sneakylizard123-4/STM32H743/images/schematic/03-clock.png

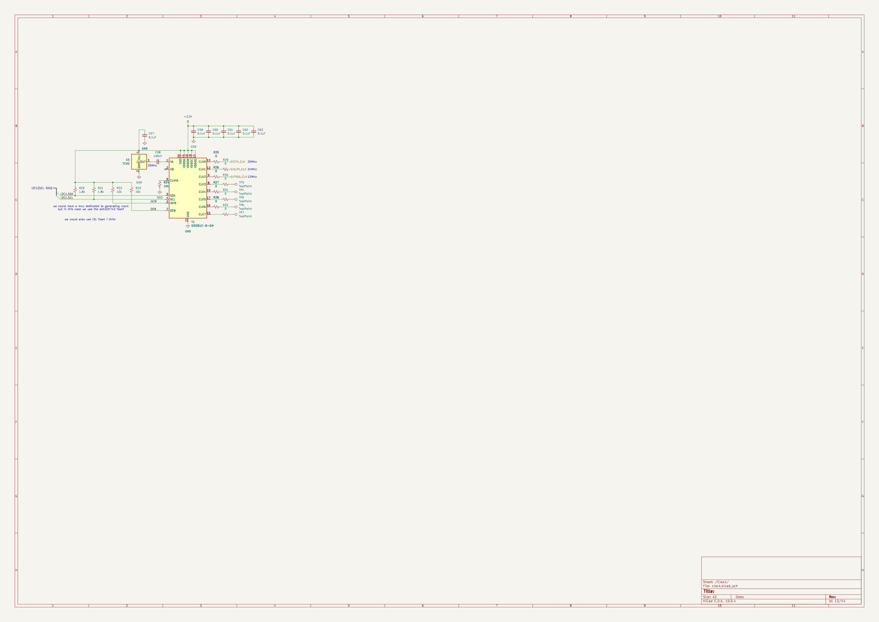
images/schematic/03-clock.png
