sneakylizard123-4/STM32H743/images/schematic/04-mcu.png

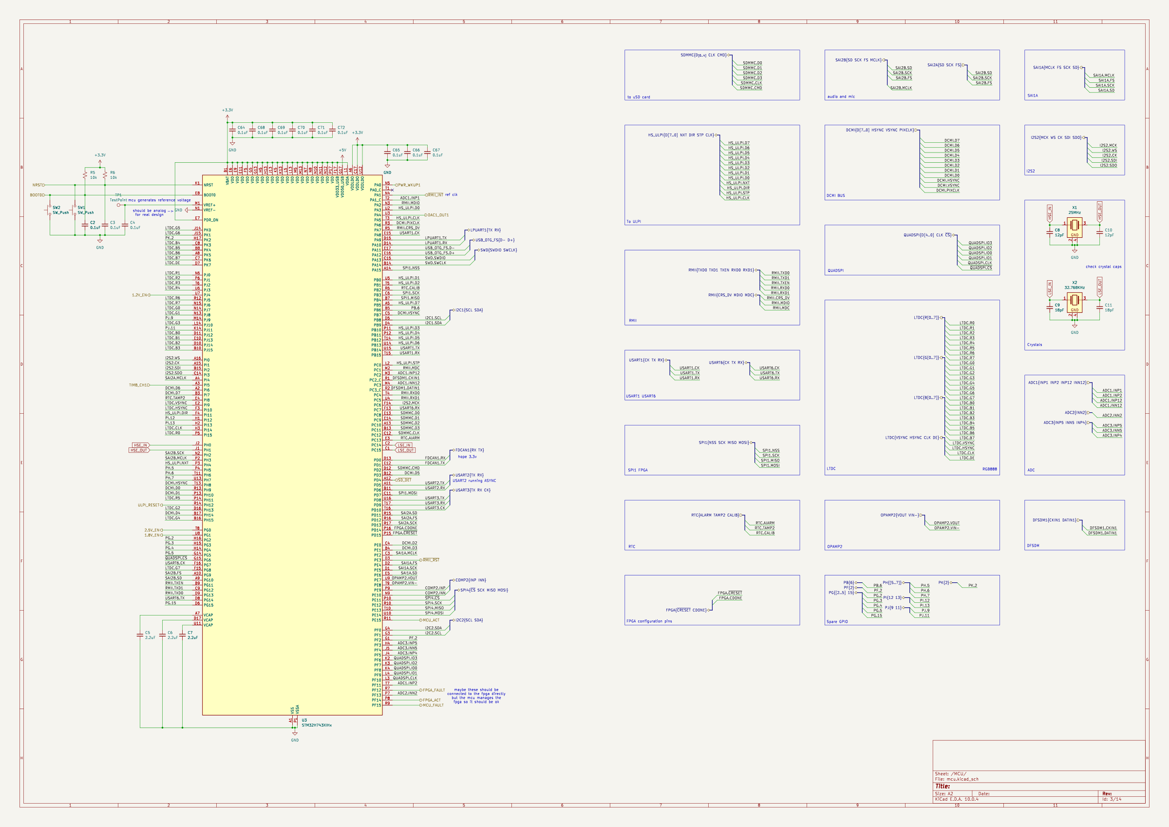
images/schematic/04-mcu.png
