sneakylizard123-4/STM32H743/images/schematic/05-fpga.png

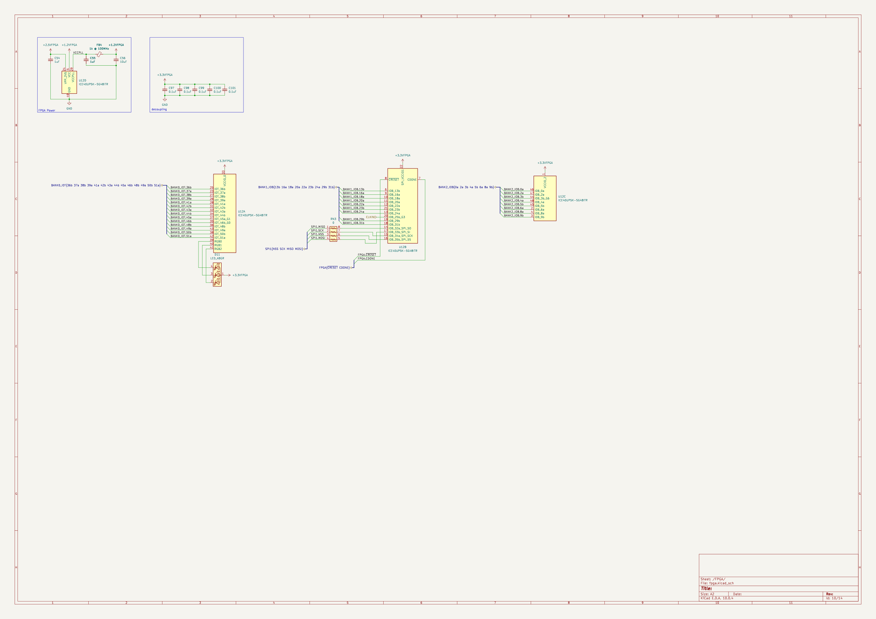
images/schematic/05-fpga.png
