sneakylizard123-4/STM32H743/images/schematic/06-ulpi.png

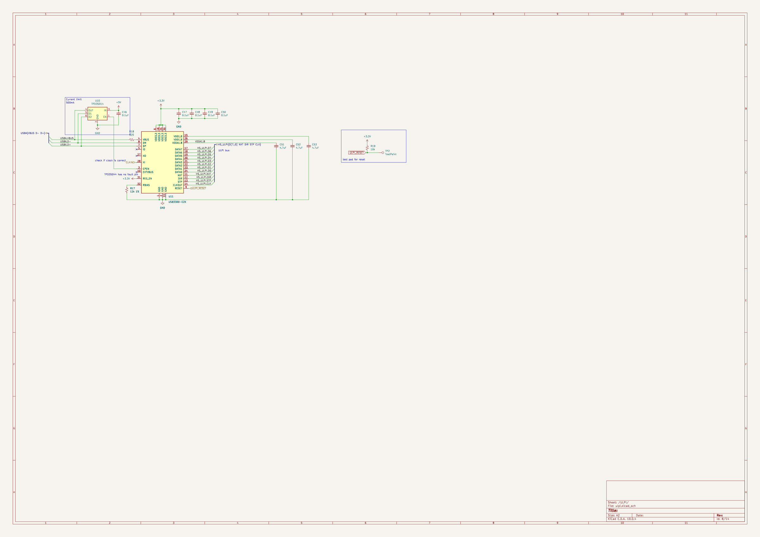
images/schematic/06-ulpi.png
