sneakylizard123-4/STM32H743/images/schematic/07-usb.png

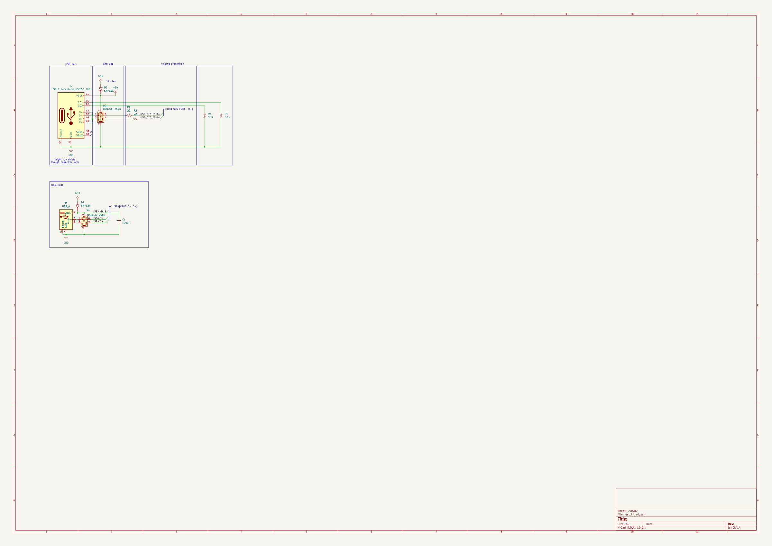
images/schematic/07-usb.png
