sneakylizard123-4/STM32H743/images/schematic/08-ethernet.png

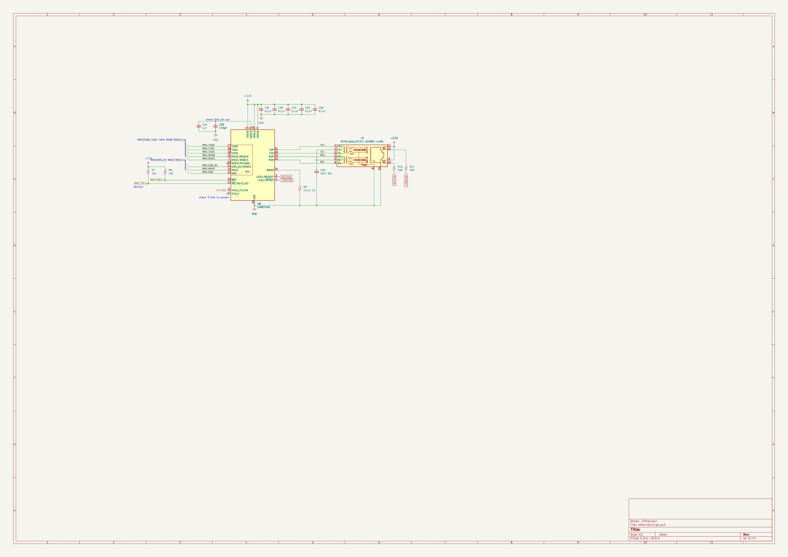
images/schematic/08-ethernet.png
