sneakylizard123-4/STM32H743/images/schematic/09-audio.png

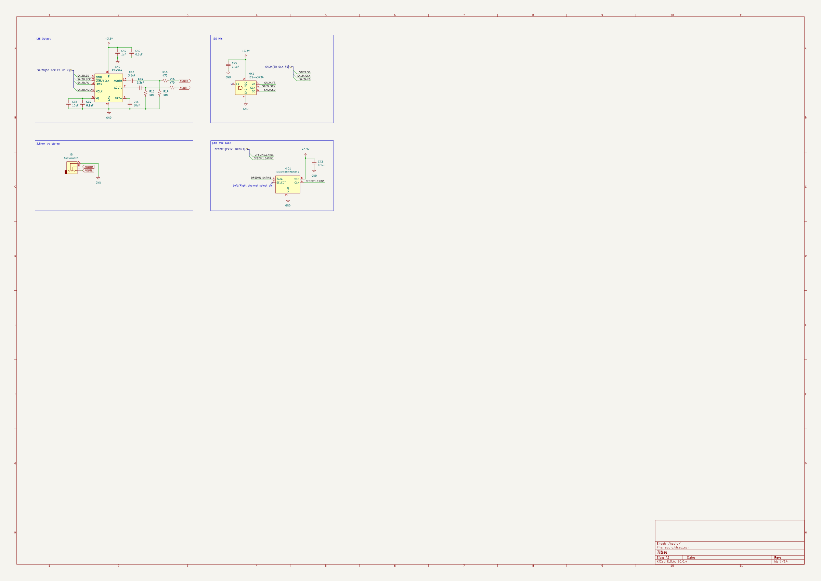
images/schematic/09-audio.png
