sneakylizard123-4/STM32H743/images/schematic/12-gpio.png

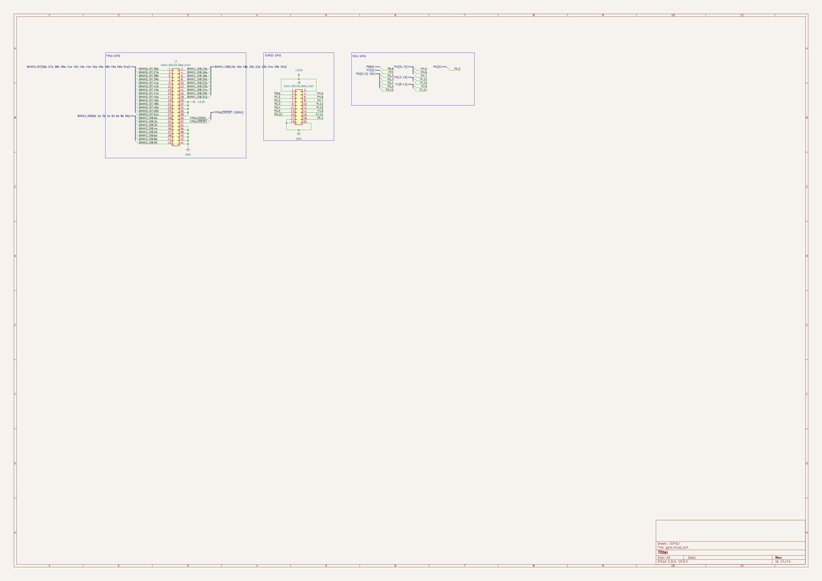
images/schematic/12-gpio.png
