sneakylizard123-4/STM32H743/images/schematic/13-connector.png

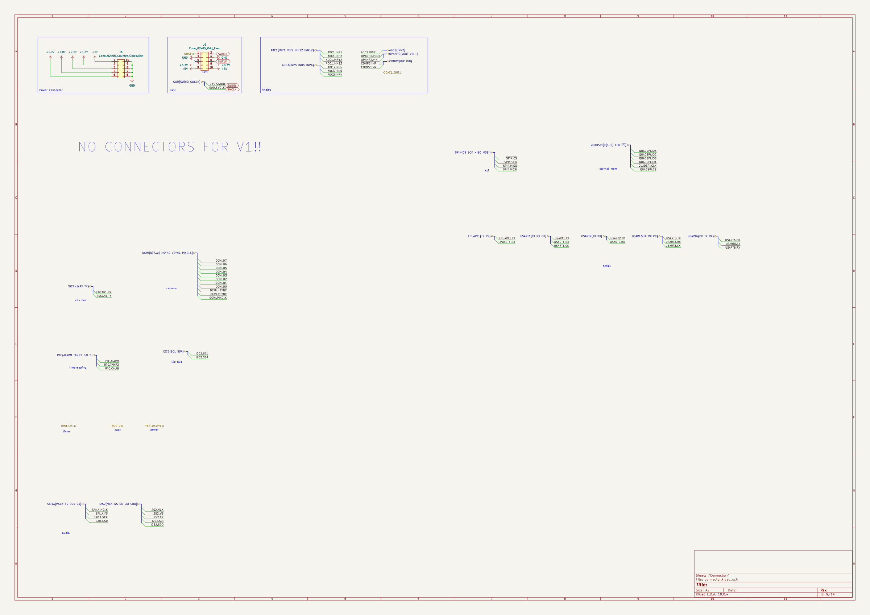
images/schematic/13-connector.png
