sneakylizard123-4/STM32H743/images/schematic/14-leds.png

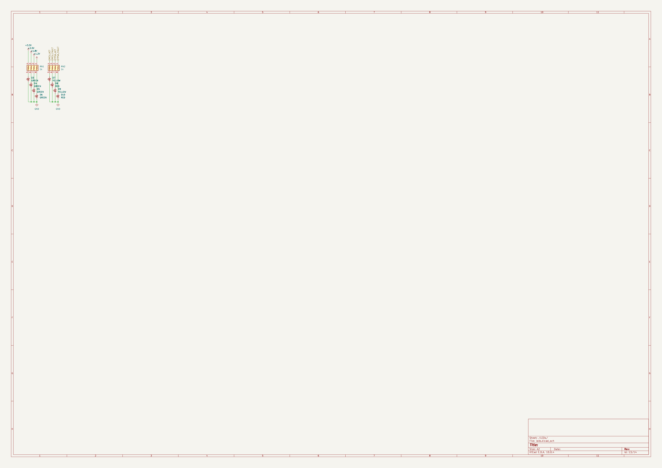
images/schematic/14-leds.png
