sneakylizard123-4/STM32H743/BOM.csv

Comment | Designators | Footprint | Quantity | Supplier | Supplier Part | Unit Price (USD) | Extended Price (USD) | Supplier Link | Notes
STM32H743XIH6 | U3 | TFBGA-265 | 1 | LCSC | C114407 | 25.9662 | 25.9662 | https://www.lcsc.com/product-detail/C114407.html | Main MCU, 480 MHz, 2 MB flash
ICE40UP5K-SG48I | U12 | QFN-48-EP 7x7 | 1 | LCSC | C2678152 | 10.9007 | 10.9007 | https://www.lcsc.com/product-detail/C2678152.html | Substitute for obsolete ICE40UP5K-SG48ITR, same package
USB3300-EZK-TR | U11 | QFN-32 | 1 | LCSC | C108383 | 1.4647 | 1.4647 | https://www.lcsc.com/product-detail/C108383.html | USB 2.0 HS ULPI PHY
LAN8742A-CZ-TR | U8 | QFN-24-EP 4x4 | 1 | LCSC | C621424 | 1.4025 | 1.4025 | https://www.lcsc.com/product-detail/C621424.html | 10/100 Ethernet PHY
CS4344-CZZR | U9 | TSSOP-10 | 1 | LCSC | C8952 | 1.5154 | 1.5154 | https://www.lcsc.com/product-detail/C8952.html | Stereo I2S audio DAC
Si5351C-B-GM | Y1 | QFN-20 | 1 | LCSC | C3608122 | 5.5527 | 5.5527 | https://www.lcsc.com/product-detail/C3608122.html | Clock generator
TLV75733PDBV | U4 | SOT-23-5 | 1 | LCSC | C485517 | 0.2005 | 0.2005 | https://www.lcsc.com/product-detail/C485517.html | 3.3 V LDO
TLV75725PDBV | U5 | SOT-23-5 | 1 | LCSC | C2872563 | 0.2318 | 0.2318 | https://www.lcsc.com/product-detail/C2872563.html | 2.5 V LDO
TLV75718PDBV | U6 | SOT-23-5 | 1 | LCSC | C507270 | 0.2985 | 0.2985 | https://www.lcsc.com/product-detail/C507270.html | 1.8 V LDO
TLV75712PDBV | U7 | SOT-23-5 | 1 | LCSC | C1509296 | 0.3415 | 0.3415 | https://www.lcsc.com/product-detail/C1509296.html | 1.2 V LDO
USBLC6-2SC6 | U1 U2 | SOT-23-6 | 2 | LCSC | C7519 | 0.1797 | 0.3594 | https://www.lcsc.com/product-detail/C7519.html | USB ESD protection
TPD3S014DBVR | U10 | SOT-23-6 | 1 | LCSC | C87384 | 1.0327 | 1.0327 | https://www.lcsc.com/product-detail/C87384.html | USB-A host power switch and protection
ICS-43434 | MK1 | LGA-6 3.5x2.7 | 1 | LCSC | C5656610 | 4.6035 | 4.6035 | https://www.lcsc.com/product-detail/C5656610.html | PDM microphone
MMICT390200012 | MIC1 | LGA | 1 | LCSC | C3171752 | 1.5613 | 1.5613 | https://www.lcsc.com/product-detail/C3171752.html | PDM microphone
CLMVC-FKA-CLBDGL7LBB79353 | D11 | PLCC-4 | 1 | Mouser | 941-CLMVCFKACLBDGL7L | 0.1400 | 0.1400 | https://www.mouser.ca/en/ProductDetail/Cree-LED/CLMVC-FKA-CLBDGL7LBB79353?qs=fSnNYG2PaKLnACIKsEWrKA%3D%3D | RGB LED, ABGR
0.1 uF 50 V X7R | C100 C101 C2 C3 C37 C39 C4 C42 C45 C46 C47 C48 C49 C50 C57 C59 C60 C61 C62 C63 C64 C65 C66 C67 C68 C69 C70 C71 C72 C73 C92 C93 C94 C95 C96 C97 C98 C99 C12 C13 C14 C15 C20 C21 C22 C23 C58 | 0603 | 47 | LCSC | C14663 | 0.0084 | 0.3948 | https://www.lcsc.com/product-detail/C14663.html | Includes both 0.1 uF and 100 nF values
10 uF 25 V X5R | C16 C17 C18 C19 C24 C25 C26 C27 C38 C41 C56 | 0603 | 11 | LCSC | C96446 | 0.0429 | 0.4719 | https://www.lcsc.com/product-detail/C96446.html
1 uF 25 V X7R | C28 C29 C30 C31 C32 C33 C34 C40 C54 C55 | 0603 | 10 | LCSC | C29936 | 0.0177 | 0.1770 | https://www.lcsc.com/product-detail/C29936.html
2.2 uF 25 V X7R | C5 C6 C7 | 0603 | 3 | LCSC | C99228 | 0.0567 | 0.1701 | https://www.lcsc.com/product-detail/C99228.html
4.7 uF 25 V X5R | C51 C52 C53 | 0603 | 3 | LCSC | C69335 | 0.0428 | 0.1284 | https://www.lcsc.com/product-detail/C69335.html
3.3 uF 25 V X5R | C43 C44 | 0603 | 2 | LCSC | C5360803 | 0.0142 | 0.0284 | https://www.lcsc.com/product-detail/C5360803.html
22 nF 50 V X7R | C36 | 0603 | 1 | LCSC | C21122 | 0.0071 | 0.0071 | https://www.lcsc.com/product-detail/C21122.html
470 pF 50 V C0G | C35 | 0603 | 1 | LCSC | C106211 | 0.0069 | 0.0069 | https://www.lcsc.com/product-detail/C106211.html
12 pF 50 V C0G | C8 C10 | 0603 | 2 | LCSC | C38523 | 0.0112 | 0.0224 | https://www.lcsc.com/product-detail/C38523.html
18 pF 50 V C0G | C9 C11 | 0603 | 2 | LCSC | C1647 | 0.0158 | 0.0316 | https://www.lcsc.com/product-detail/C1647.html
47 uF 6.3 V X5R | C1 | 0603 | 1 | LCSC | C140782 | 0.1382 | 0.1382 | https://www.lcsc.com/product-detail/C140782.html | Rev A value was 120 uF, which does not fit 0603. This is below the USB 2.0 host 120 uF recommendation.
12.1 k 1% | R9 | 0603 | 1 | LCSC | C22864 | 0.0015 | 0.0015 | https://www.lcsc.com/product-detail/C22864.html
SMF12A | D1 D2 | SOD-123FL | 2 | LCSC | C19077506 | 0.0325 | 0.0650 | https://www.lcsc.com/product-detail/C19077506.html | TVS
1 k at 100 MHz ferrite | FB1 FB2 FB3 FB4 | 0603 | 4 | LCSC | C304312 | 0.0150 | 0.0600 | https://www.lcsc.com/product-detail/C304312.html
Green LED | D3 D4 D5 D6 | 0603 | 4 | LCSC | C52675989 | 0.0035 | 0.0140 | https://www.lcsc.com/product-detail/C52675989.html
Yellow LED | D7 D9 | 0603 | 2 | LCSC | C965802 | 0.0072 | 0.0144 | https://www.lcsc.com/product-detail/C965802.html
Red LED | D8 D10 | 0603 | 2 | LCSC | C2286 | 0.0077 | 0.0154 | https://www.lcsc.com/product-detail/C2286.html
1 k resistor array x4 | RN1 RN2 | 0603x4 | 2 | LCSC | C20197 | 0.0104 | 0.0208 | https://www.lcsc.com/product-detail/C20197.html
0 ohm resistor array x4 | RN3 | 0603x4 | 1 | LCSC | C1952 | 0.0090 | 0.0090 | https://www.lcsc.com/product-detail/C1952.html
22 ohm | R1 R2 | 0603 | 2 | LCSC | C23345 | 0.0017 | 0.0034 | https://www.lcsc.com/product-detail/C23345.html | USB series termination
330 ohm | R10 R11 | 0603 | 2 | LCSC | C23138 | 0.0020 | 0.0040 | https://www.lcsc.com/product-detail/C23138.html
10 k | R5 R6 R7 R8 R12 R13 R14 R19 R22 R23 R24 | 0603 | 11 | LCSC | C25804 | 0.0022 | 0.0242 | https://www.lcsc.com/product-detail/C25804.html
470 ohm | R15 R16 | 0603 | 2 | LCSC | C23179 | 0.0023 | 0.0046 | https://www.lcsc.com/product-detail/C23179.html
12 k 1% | R17 | 0603 | 1 | LCSC | C22790 | 0.0031 | 0.0031 | https://www.lcsc.com/product-detail/C22790.html
820 ohm | R18 | 0603 | 1 | LCSC | C23253 | 0.0015 | 0.0015 | https://www.lcsc.com/product-detail/C23253.html
1.8 k | R20 R21 | 0603 | 2 | LCSC | C4177 | 0.0021 | 0.0042 | https://www.lcsc.com/product-detail/C4177.html
0 ohm | R25 R26 R27 R28 R29 R30 R31 R32 | 0603 | 8 | LCSC | C21189 | 0.0022 | 0.0176 | https://www.lcsc.com/product-detail/C21189.html
5.1 k | R3 R4 | 0603 | 2 | LCSC | C23186 | 0.0015 | 0.0030 | https://www.lcsc.com/product-detail/C23186.html | USB-C CC pulldowns
USB-A DS1095 | J1 | USB-A THT | 1 | LCSC | C19944602 | 0.2097 | 0.2097 | https://www.lcsc.com/product-detail/C19944602.html | Connfly DS1095-WNM0
USB-C 16P | J2 | USB-C SMD | 1 | LCSC | C165948 | 0.1869 | 0.1869 | https://www.lcsc.com/product-detail/C165948.html | HRO TYPE-C-31-M-12
RJ45 with magnetics | J3 | RJ45 horizontal | 1 | Mouser | 493-HFJ112450EL12RL | 4.5000 | 4.5000 | https://www.mouser.ca/en/ProductDetail/HALO-Electronics/HFJ11-2450E-L12RL?qs=8uu3sA0mUduNJw%2FtWFBLbA%3D%3D | Halo HFJ11-2450E-L12RL
microSD socket | J4 | microSD SMD | 1 | LCSC | C719027 | 1.1652 | 1.1652 | https://www.lcsc.com/product-detail/C719027.html | Hirose DM3D-SF
3.5 mm audio jack | J5 | SJ-3523-SMT | 1 | Mouser | 490-SJ-3523-SMT-TR | 0.8800 | 0.8800 | https://www.mouser.ca/en/ProductDetail/Same-Sky/SJ-3523-SMT-TR?qs=WyjlAZoYn51zOHzJ3r4ZRA%3D%3D | CUI SJ-3523-SMT-TR
2x5 socket | J6 | 2x5 2.54 mm | 1 | LCSC | C492399 | 0.1149 | 0.1149 | https://www.lcsc.com/product-detail/C492399.html
2x22 socket | J7 | 2x22 2.54 mm | 1 | LCSC | C27985237 | 0.4010 | 0.4010 | https://www.lcsc.com/product-detail/C27985237.html
2x10 socket | J8 | 2x10 2.54 mm | 1 | LCSC | C2897411 | 0.3264 | 0.3264 | https://www.lcsc.com/product-detail/C2897411.html
2x5 header | J9 | 2x5 2.54 mm | 1 | LCSC | C492422 | 0.0662 | 0.0662 | https://www.lcsc.com/product-detail/C492422.html
EVQ-PUM02K | SW1 SW2 | SMD 4.7x4.5 mm | 2 | Mouser | 667-EVQ-PUM02K | 0.5700 | 1.1400 | https://www.mouser.ca/en/ProductDetail/Panasonic-Industry/EVQ-PUM02K?qs=WwqriLBepZvbR6KlByvVlg%3D%3D | Panasonic tactile switch
25 MHz crystal | X1 | 3225 4-pad | 1 | LCSC | C9006 | 0.0951 | 0.0951 | https://www.lcsc.com/product-detail/C9006.html | 12 pF load
32.768 kHz crystal | X2 | 3215 2-pad | 1 | LCSC | C32346 | 0.1709 | 0.1709 | https://www.lcsc.com/product-detail/C32346.html | Current PCB uses a 3225 4-pad footprint. Rev B must change the footprint to 3215 2-pad before ordering.
25 MHz TCXO | X3 | 2520 4-pad | 1 | LCSC | C48994904 | 0.4534 | 0.4534 | https://www.lcsc.com/product-detail/C48994904.html | 3.3 V clipped sine, +/-0.5 ppm
PCB fabrication, 6 layer, 104.27 x 81.00 mm, qty 5 | PCB1 | 6-layer 1.6 mm | 5 | JLCPCB | PCB quote | 11.4000 | 57.0000 | https://jlcpcb.com/ | Estimate only. Final price depends on options and date.
Shipping, global standard direct line | SHIP1 |  | 1 | JLCPCB | Shipping quote | 18.0000 | 18.0000 | https://jlcpcb.com/help/article/shipping-methods | Estimate only. Do not use express couriers.
TOTAL |  |  |  |  |  |  | 142.12 |  | Components USD 67.12 for one board, PCB estimate USD 57.00 for five boards, shipping estimate USD 18.00
