sneakylizard123-4/STM32H743/kicad/production/bom.csv

Designator | Footprint | Quantity | Value | LCSC Part #
C1 | 0603 | 1 | 120uF
C10, C8 | 0603 | 2 | 12pF
C100, C101, C2, C3, C37, C39, C4, C42, C45, C46, C47, C48, C49, C50, C57, C59, C60, C61, C62, C63, C64, C65, C66, C67, C68, C69, C70, C71, C72, C73, C92, C93, C94, C95, C96, C97, C98, C99 | 0603 | 38 | 0.1uF
C11, C9 | 0603 | 2 | 18pF
C12, C13, C14, C15, C20, C21, C22, C23, C58 | 0603 | 9 | 100nF
C16, C17, C18, C19, C24, C25, C26, C27, C38, C41, C56 | 0603 | 11 | 10uF
C28, C29, C30, C31, C32, C33, C34, C40, C54, C55 | 0603 | 10 | 1uF
C35 | 0603 | 1 | 470pF
C36 | 0603 | 1 | 22nF 50v
C43, C44 | 0603 | 2 | 3.3uF
C5, C6, C7 | 0603 | 3 | 2.2uF
C51, C52, C53 | 0603 | 3 | 4.7uF
D1, D2 | D_SMF | 2 | SMF12A
D10, D8 | 0603 | 2 | RED
D11 | LED_Cree-PLCC4_2x2mm_CW | 1 | LED_ABGR | C5620247
D3, D4, D5, D6 | 0603 | 4 | GREEN
D7, D9 | 0603 | 2 | YELLOW
FB1, FB2, FB3, FB4 | Ferrite_0603_1608Metric | 4 | 1k @ 100MHz
J1 | USB_A_Connfly_DS1095 | 1 | USB_A
J2 | USB_C_Receptacle_HRO_TYPE-C-31-M-12 | 1 | USB_C_Receptacle_USB2.0_16P
J3 | RJ45_HALO_HFJ11-x2450E-LxxRL_Horizontal | 1 | RJ45_Halo_HFJ11-x2450E-LxxRL
J4 | microSD_HC_Hirose_DM3D-SF | 1 | Micro_SD_Card_Det2
J5 | Jack_3.5mm_CUI_SJ-3523-SMT_Horizontal | 1 | AudioJack3
J6 | PinSocket_2x05_P2.54mm_Vertical | 1 | Conn_02x05_Counter_Clockwise
J7 | PinSocket_2x22_P2.54mm_Vertical | 1 | Conn_02x22_Odd_Even
J8 | PinSocket_2x10_P2.54mm_Vertical | 1 | Conn_02x10_Odd_Even
J9 | PinHeader_2x05_P2.54mm_Vertical | 1 | Conn_02x05_Odd_Even
MIC1 | MIC-SMD_5P-L3.5-W2.7-TL_MMICT390200012 | 1 | MMICT390200012 | C3171752
MK1 | InvenSense_ICS-43434-6_3.5x2.65mm | 1 | ICS-43434
R1, R2 | 0603 | 2 | 22
R10, R11 | 0603 | 2 | 330
R12, R13, R14, R19, R22, R23, R24, R5, R6, R7, R8 | 0603 | 11 | 10k
R15, R16 | 0603 | 2 | 470
R17 | 0603 | 1 | 12k 1%
R18 | 0603 | 1 | 820
R20, R21 | 0603 | 2 | 1.8k
R25, R26, R27, R28, R29, R30, R31, R32 | 0603 | 8 | 0
R3, R4 | 0603 | 2 | 5.1k
R9 | 0603 | 1 | 12.1k 1%
RN1, RN2 | R_Array_Concave_4x0603 | 2 | 1k
RN3 | R_Array_Concave_4x0603 | 1 | 0
SW1, SW2 | Panasonic_EVQPUM_EVQPUD | 2 | SW_Push
U1, U2 | SOT-23-6 | 2 | USBLC6-2SC6
U10 | SOT-23-6 | 1 | TPD3S014
U11 | QFN-32-1EP_5x5mm_P0.5mm_EP3.45x3.45mm | 1 | USB3300-EZK
U12 | QFN-48-1EP_7x7mm_P0.5mm_EP5.6x5.6mm | 1 | ICE40UP5K-SG48ITR
U3 | TFBGA-265_14x14mm_Layout17x17_P0.8mm | 1 | STM32H743XIHx
U4 | SOT-23-5 | 1 | TLV75733PDBV
U5 | SOT-23-5 | 1 | TLV75725PDBV
U6 | SOT-23-5 | 1 | TLV75718PDBV
U7 | SOT-23-5 | 1 | TLV75712PDBV
U8 | VQFN-24-1EP_4x4mm_P0.5mm_EP2.5x2.5mm_ThermalVias | 1 | LAN8742A
U9 | TSSOP-10_3x3mm_P0.5mm | 1 | CS4344
X1 | Crystal_SMD_3225-4Pin_3.2x2.5mm | 1 | 25MHz
X2 | Crystal_SMD_3225-4Pin_3.2x2.5mm | 1 | 32.768KHz
X3 | Oscillator_SMD_SeikoEpson_TG2520SMN-xxx-xxxxxx-4Pin_2.5x2.0mm | 1 | TCXO
Y1 | QFN-20-1EP_4x4mm_P0.5mm_EP2.7x2.7mm | 1 | Si5351C-B-GM
