sneakylizard123-4/STM32H743/cad/STM32H743.step

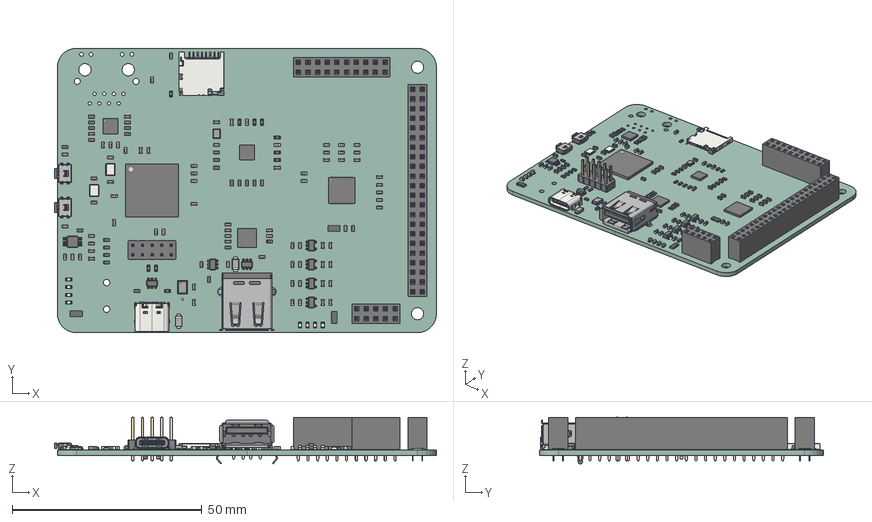
[picture p15: CAD file, 2026-10-25]
cad/STM32H743.step
100.8 x 75.0 x 12.3 mm
C_0603_1608Metric x 83
LED_0603_1608Metric x 8
R_0603_1608Metric x 32
R_Array_Concave_4x0603 x 3
SOT-23-5 x 4
L_0603_1608Metric x 4
Panasonic_EVQPUM_EVQPUD x 2
PinSocket_2x05_P2.54mm_Vertical
SOT-23-6 x 3
D_SMF x 2
QFN-24-1EP_4x4mm_P0.5mm_EP2.7x2.7mm
TFBGA-265_14x14mm_Layout17x17_P0.8mm
Crystal_SMD_3225-4Pin_3.2x2.5mm x 2
PinSocket_2x22_P2.54mm_Vertical
TSSOP-10_3x3mm_P0.5mm
QFN-20-1EP_4x4mm_Pitch0.5mm
Crystal_SMD_2520-4Pin_2.5x2.0mm
InvenSense_ICS-43434-6_3.5x2.65mm
QFN-32-1EP_5x5mm_Pitch0.5mm
microSD_HC_Hirose_DM3D-SF
QFN-48-1EP_7x7mm_Pitch0.5mm
USB_A_Molex_67643_Horizontal
PinSocket_2x10_P2.54mm_Vertical
USB_C_Receptacle_16P_TopMnt_Horizontal_GCT_USB4105-xx-A
PinHeader_2x05_P254mm_Vertical
STM32H743_PCB
