sneakylizard123-4/STM32H743/parts/ADV7513BSWZ/ADV7513BSWZ.step

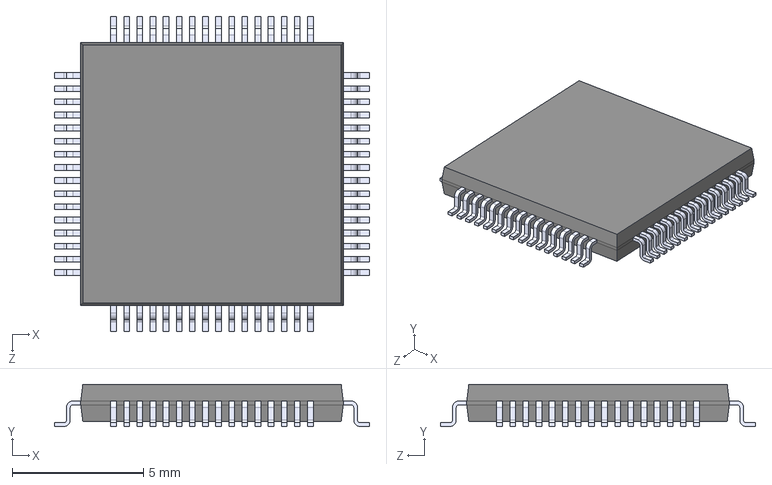
[picture p16: CAD file, 2026-10-07]
parts/ADV7513BSWZ/ADV7513BSWZ.step
12.0 x 1.60 x 12.0 mm
