sneakylizard123-4/STM32H743/(list of files, cad)

Other CAD files:
blender/STM32H743XIH6.blend
