sneakylizard123-4/STM32H743/kicad/STM32H743.kicad_pcb

## KiCad design kicad/STM32H743.kicad_pcb (2026-10-27)

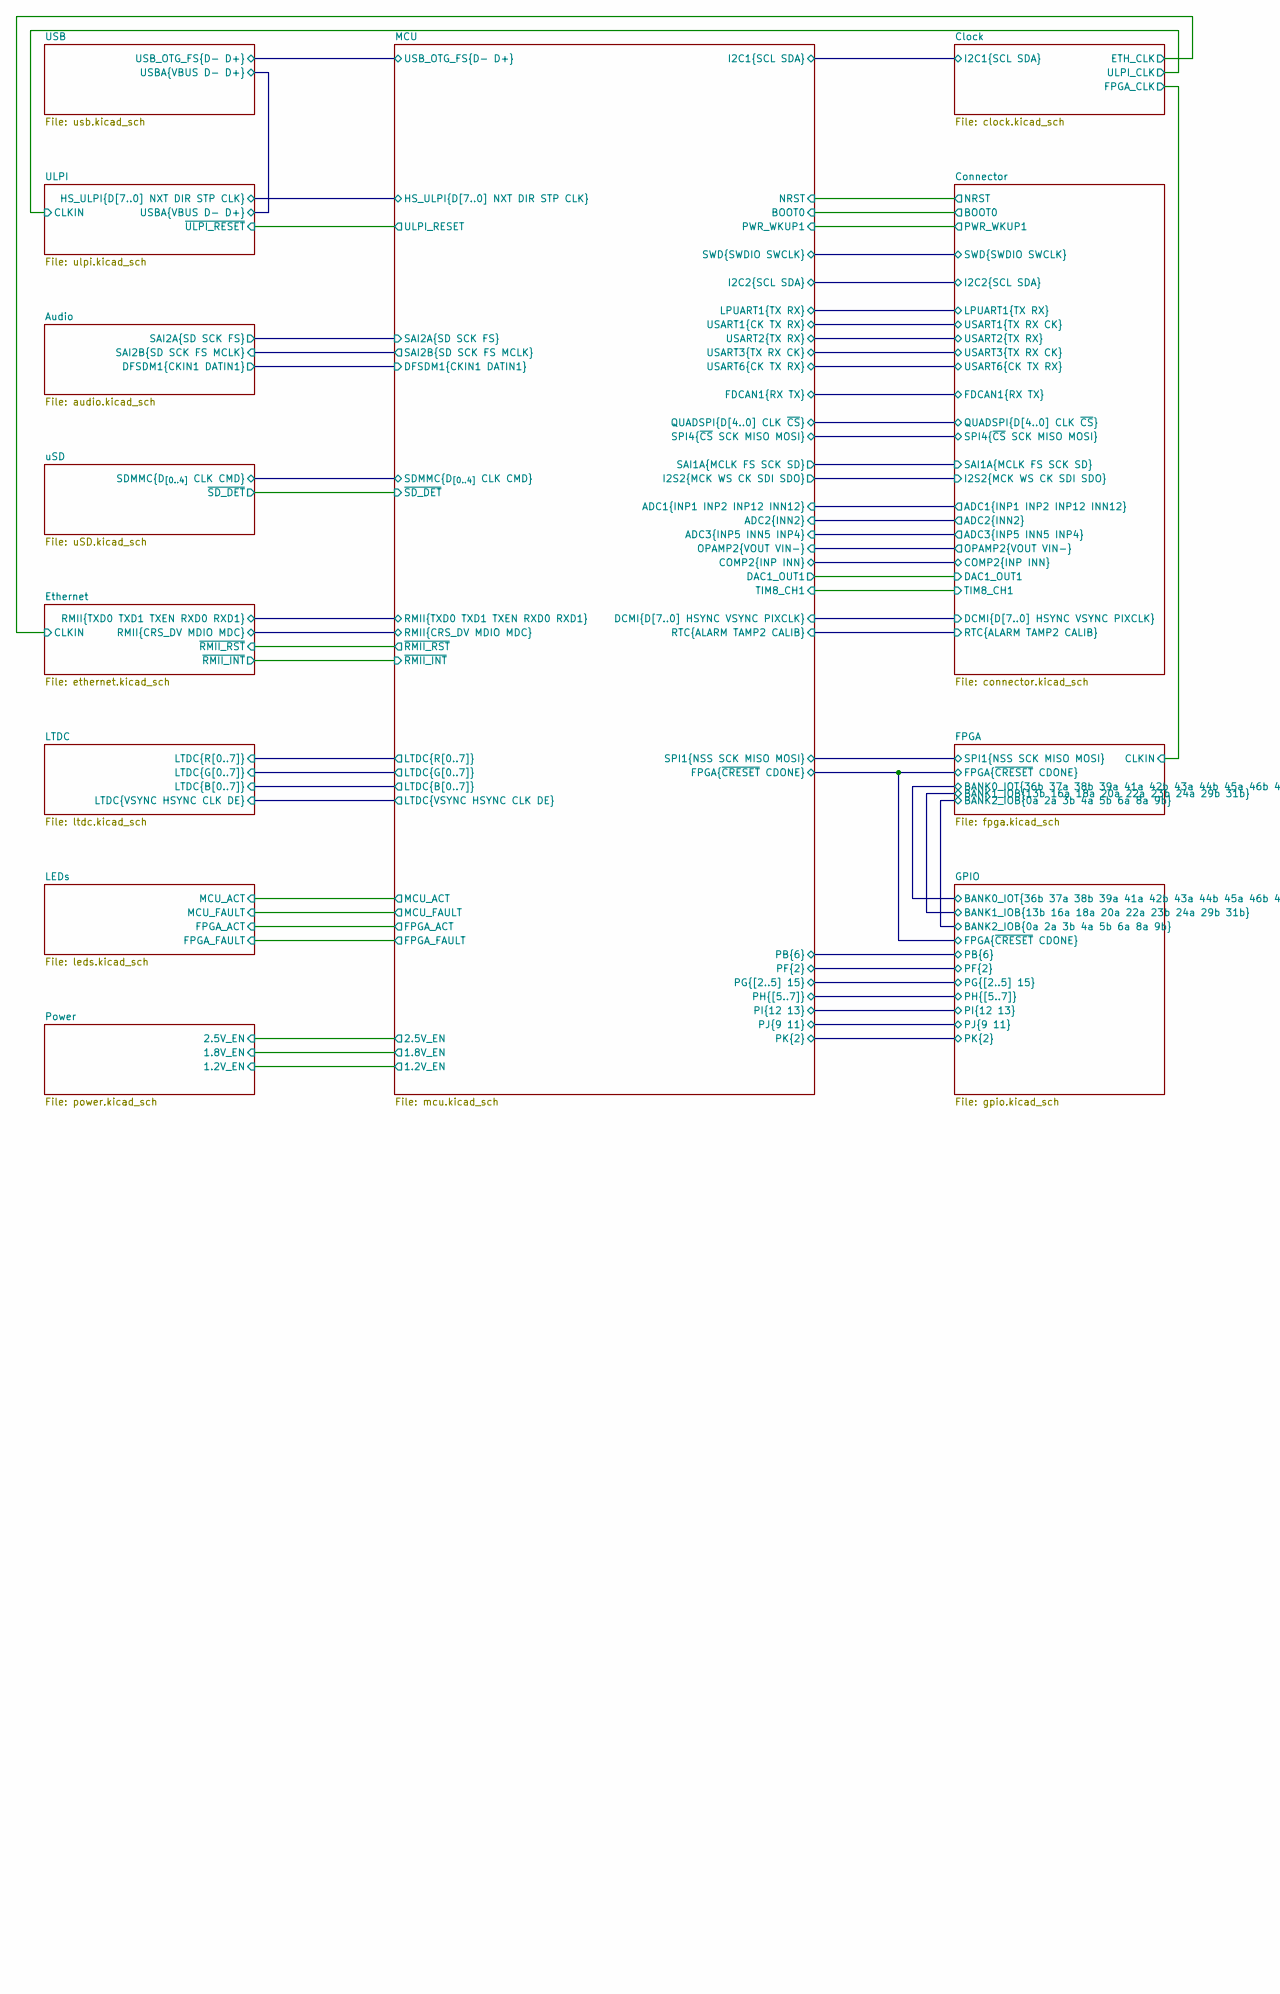
[picture p48: schematic STM32H743.kicad_sch, part in row 1, column 1]

Parts:
H1, H2: MountingHole; MountingHole_3.2mm_M3

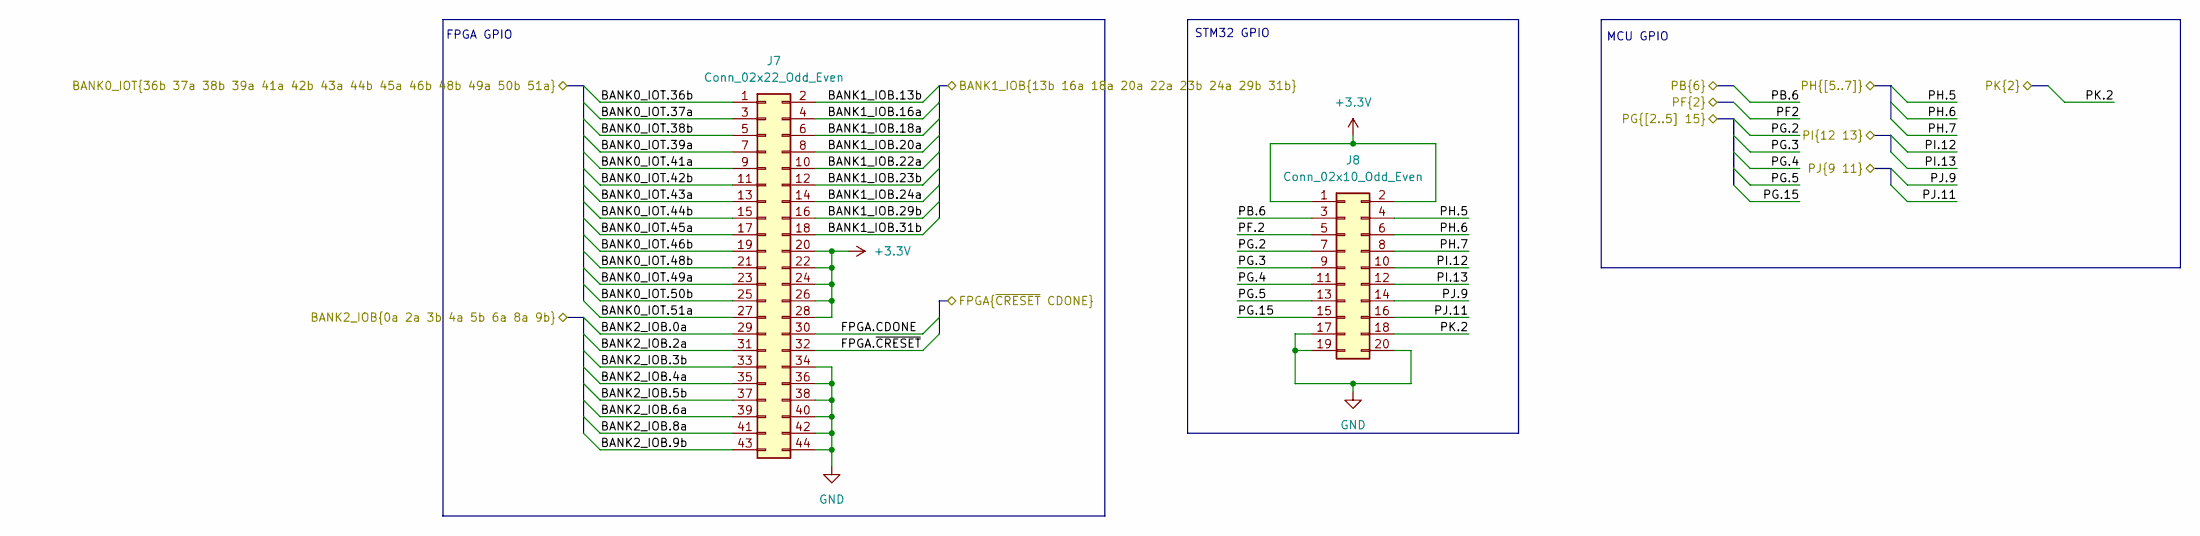
[picture p49: schematic gpio.kicad_sch]

Parts:
J7: Conn_02x22_Odd_Even; PinSocket_2x22_P2.54mm_Vertical
J8: Conn_02x10_Odd_Even; PinSocket_2x10_P2.54mm_Vertical

Connections:
+3.3V: J7.20, J7.22, J7.24, J7.26, J7.28, J8.1, J8.2; also elsewhere on the board
/FPGA/BANK0_IOT.36b: J7.1; also elsewhere on the board
/FPGA/BANK0_IOT.37a: J7.3; also elsewhere on the board
/FPGA/BANK0_IOT.38b: J7.5; also elsewhere on the board
/FPGA/BANK0_IOT.39a: J7.7; also elsewhere on the board
/FPGA/BANK0_IOT.41a: J7.9; also elsewhere on the board
/FPGA/BANK0_IOT.42b: J7.11; also elsewhere on the board
/FPGA/BANK0_IOT.43a: J7.13; also elsewhere on the board
/FPGA/BANK0_IOT.44b: J7.15; also elsewhere on the board
/FPGA/BANK0_IOT.45a: J7.17; also elsewhere on the board
/FPGA/BANK0_IOT.46b: J7.19; also elsewhere on the board
/FPGA/BANK0_IOT.48b: J7.21; also elsewhere on the board
/FPGA/BANK0_IOT.49a: J7.23; also elsewhere on the board
/FPGA/BANK0_IOT.50b: J7.25; also elsewhere on the board
/FPGA/BANK0_IOT.51a: J7.27; also elsewhere on the board
/FPGA/BANK1_IOB.13b: J7.2; also elsewhere on the board
/FPGA/BANK1_IOB.16a: J7.4; also elsewhere on the board
/FPGA/BANK1_IOB.18a: J7.6; also elsewhere on the board
/FPGA/BANK1_IOB.20a: J7.8; also elsewhere on the board
/FPGA/BANK1_IOB.22a: J7.10; also elsewhere on the board
/FPGA/BANK1_IOB.23b: J7.12; also elsewhere on the board
/FPGA/BANK1_IOB.24a: J7.14; also elsewhere on the board
/FPGA/BANK1_IOB.29b: J7.16; also elsewhere on the board
/FPGA/BANK1_IOB.31b: J7.18; also elsewhere on the board
/FPGA/BANK2_IOB.0a: J7.29; also elsewhere on the board
/FPGA/BANK2_IOB.2a: J7.31; also elsewhere on the board
/FPGA/BANK2_IOB.3b: J7.33; also elsewhere on the board
/FPGA/BANK2_IOB.4a: J7.35; also elsewhere on the board
/FPGA/BANK2_IOB.5b: J7.37; also elsewhere on the board
/FPGA/BANK2_IOB.6a: J7.39; also elsewhere on the board
/FPGA/BANK2_IOB.8a: J7.41; also elsewhere on the board
/FPGA/BANK2_IOB.9b: J7.43; also elsewhere on the board
/FPGA/FPGA.CDONE: J7.30; also elsewhere on the board
/FPGA/FPGA.~CRESET: J7.32; also elsewhere on the board
/GPIO/PB.6: J8.3; also elsewhere on the board
/GPIO/PF.2: J8.5; also elsewhere on the board
/GPIO/PG.2: J8.7; also elsewhere on the board
/GPIO/PG.3: J8.9; also elsewhere on the board
/GPIO/PG.4: J8.11; also elsewhere on the board
/GPIO/PG.5: J8.13; also elsewhere on the board
/GPIO/PG.15: J8.15; also elsewhere on the board
/GPIO/PH.5: J8.4; also elsewhere on the board
/GPIO/PH.6: J8.6; also elsewhere on the board
/GPIO/PH.7: J8.8; also elsewhere on the board
/GPIO/PI.12: J8.10; also elsewhere on the board
/GPIO/PI.13: J8.12; also elsewhere on the board
/GPIO/PJ.9: J8.14; also elsewhere on the board
/GPIO/PJ.11: J8.16; also elsewhere on the board
/GPIO/PK.2: J8.18; also elsewhere on the board
GND: J7.34, J7.36, J7.38, J7.40, J7.42, J7.44, J8.17, J8.19, J8.20; also elsewhere on the board

Notes on the sheet:
MCU GPIO
FPGA GPIO
STM32 GPIO

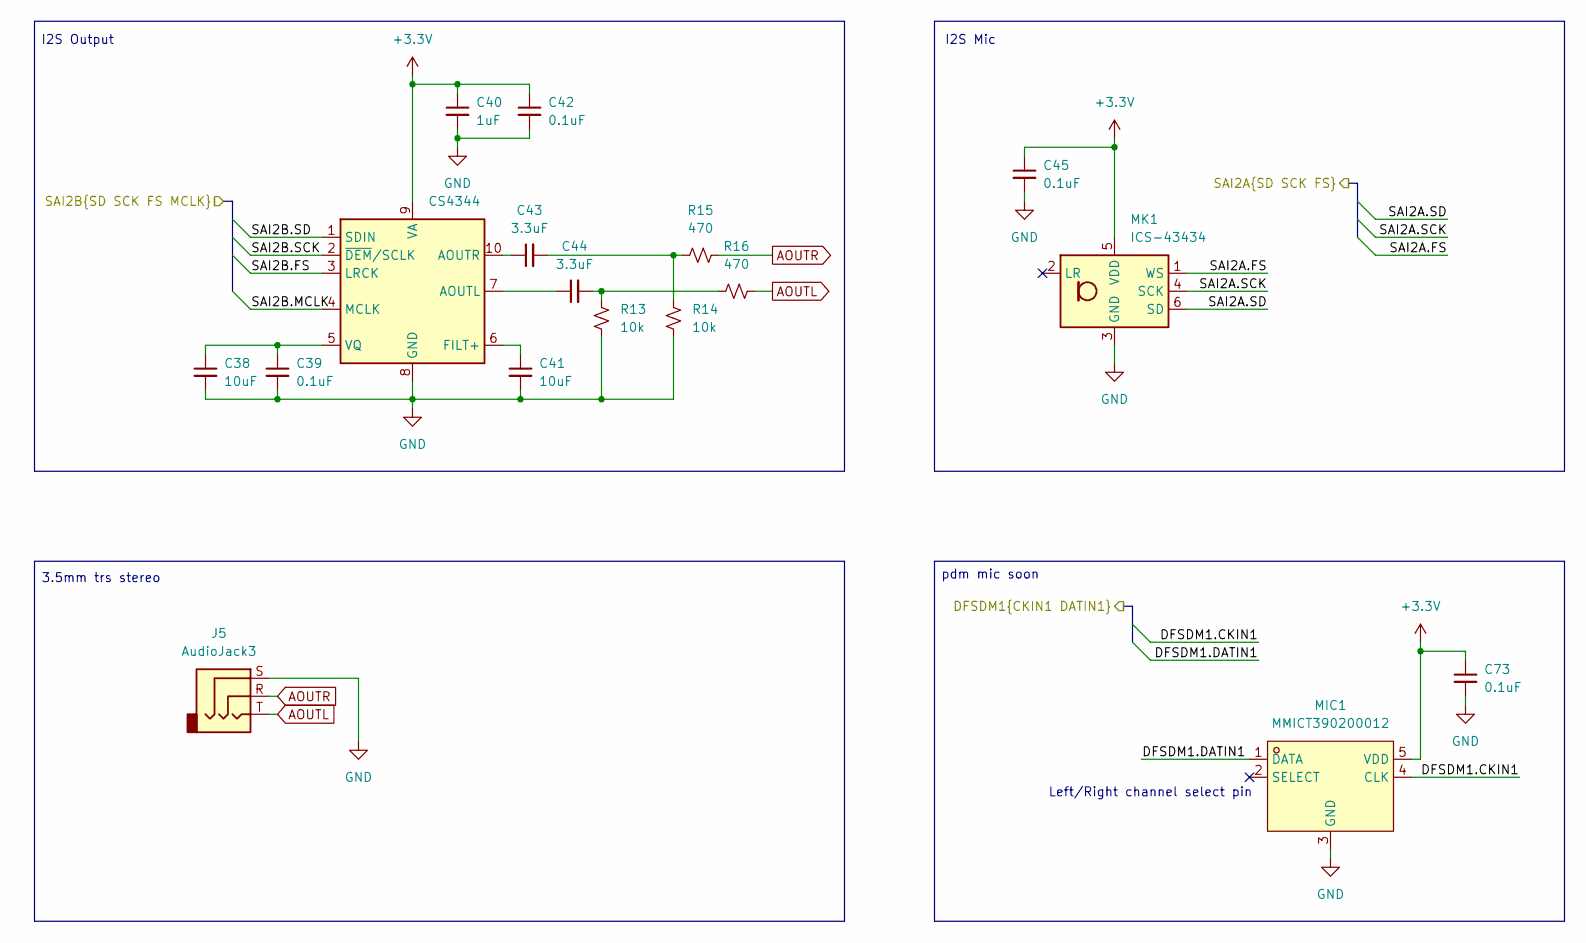
[picture p50: schematic audio.kicad_sch]

Parts:
C38, C41: 10uF; C_0603_1608Metric
C39, C42, C45, C73: 0.1uF; C_0603_1608Metric
C40: 1uF; C_0603_1608Metric
C43, C44: 3.3uF; C_0603_1608Metric
J5: AudioJack3; Jack_3.5mm_CUI_SJ-3523-SMT_Horizontal
MIC1: MMICT390200012; MIC-SMD_5P-L3.5-W2.7-TL_MMICT390200012; MPN MMICT390200012; LCSC Part C3171752
MK1: ICS-43434; InvenSense_ICS-43434-6_3.5x2.65mm
R13, R14: 10k; R_0603_1608Metric
R15, R16: 470; R_0603_1608Metric
U9: CS4344; TSSOP-10_3x3mm_P0.5mm

Connections:
+3.3V: C40.1, C42.1, C45.1, C73.1, MIC1.5 (VDD), MK1.5 (VDD), U9.9 (VA); also elsewhere on the board
/Audio/DFSDM1.CKIN1: MIC1.4 (CLK); also elsewhere on the board
/Audio/DFSDM1.DATIN1: MIC1.1 (DATA); also elsewhere on the board
/Audio/SAI2A.FS: MK1.1 (WS); also elsewhere on the board
/Audio/SAI2A.SCK: MK1.4 (SCK); also elsewhere on the board
/Audio/SAI2A.SD: MK1.6 (SD); also elsewhere on the board
/Audio/SAI2B.FS: U9.3 (LRCK); also elsewhere on the board
/Audio/SAI2B.MCLK: U9.4 (MCLK); also elsewhere on the board
/Audio/SAI2B.SCK: U9.2 (~DEM/SCLK); also elsewhere on the board
/Audio/SAI2B.SD: U9.1 (SDIN); also elsewhere on the board
AOUTL: J5.T, R16.2
AOUTR: J5.R, R15.2
GND: C38.2, C39.2, C40.2, C41.2, C42.2, C45.2, C73.2, J5.S, MIC1.3 (GND), MK1.3 (GND), R13.2, R14.2, U9.8 (GND); also elsewhere on the board
unnamed: C43.2, R14.1, R15.1
unnamed: C44.2, R13.1, R16.1
unnamed: C44.1, U9.7 (AOUTL)
unnamed: C43.1, U9.10 (AOUTR)
unnamed: C41.1, U9.6 (FILT+)
unnamed: C38.1, C39.1, U9.5 (VQ)

Notes on the sheet:
I2S Output
3.5mm trs stereo
pdm mic soon
I2S Mic
Left/Right channel select pin

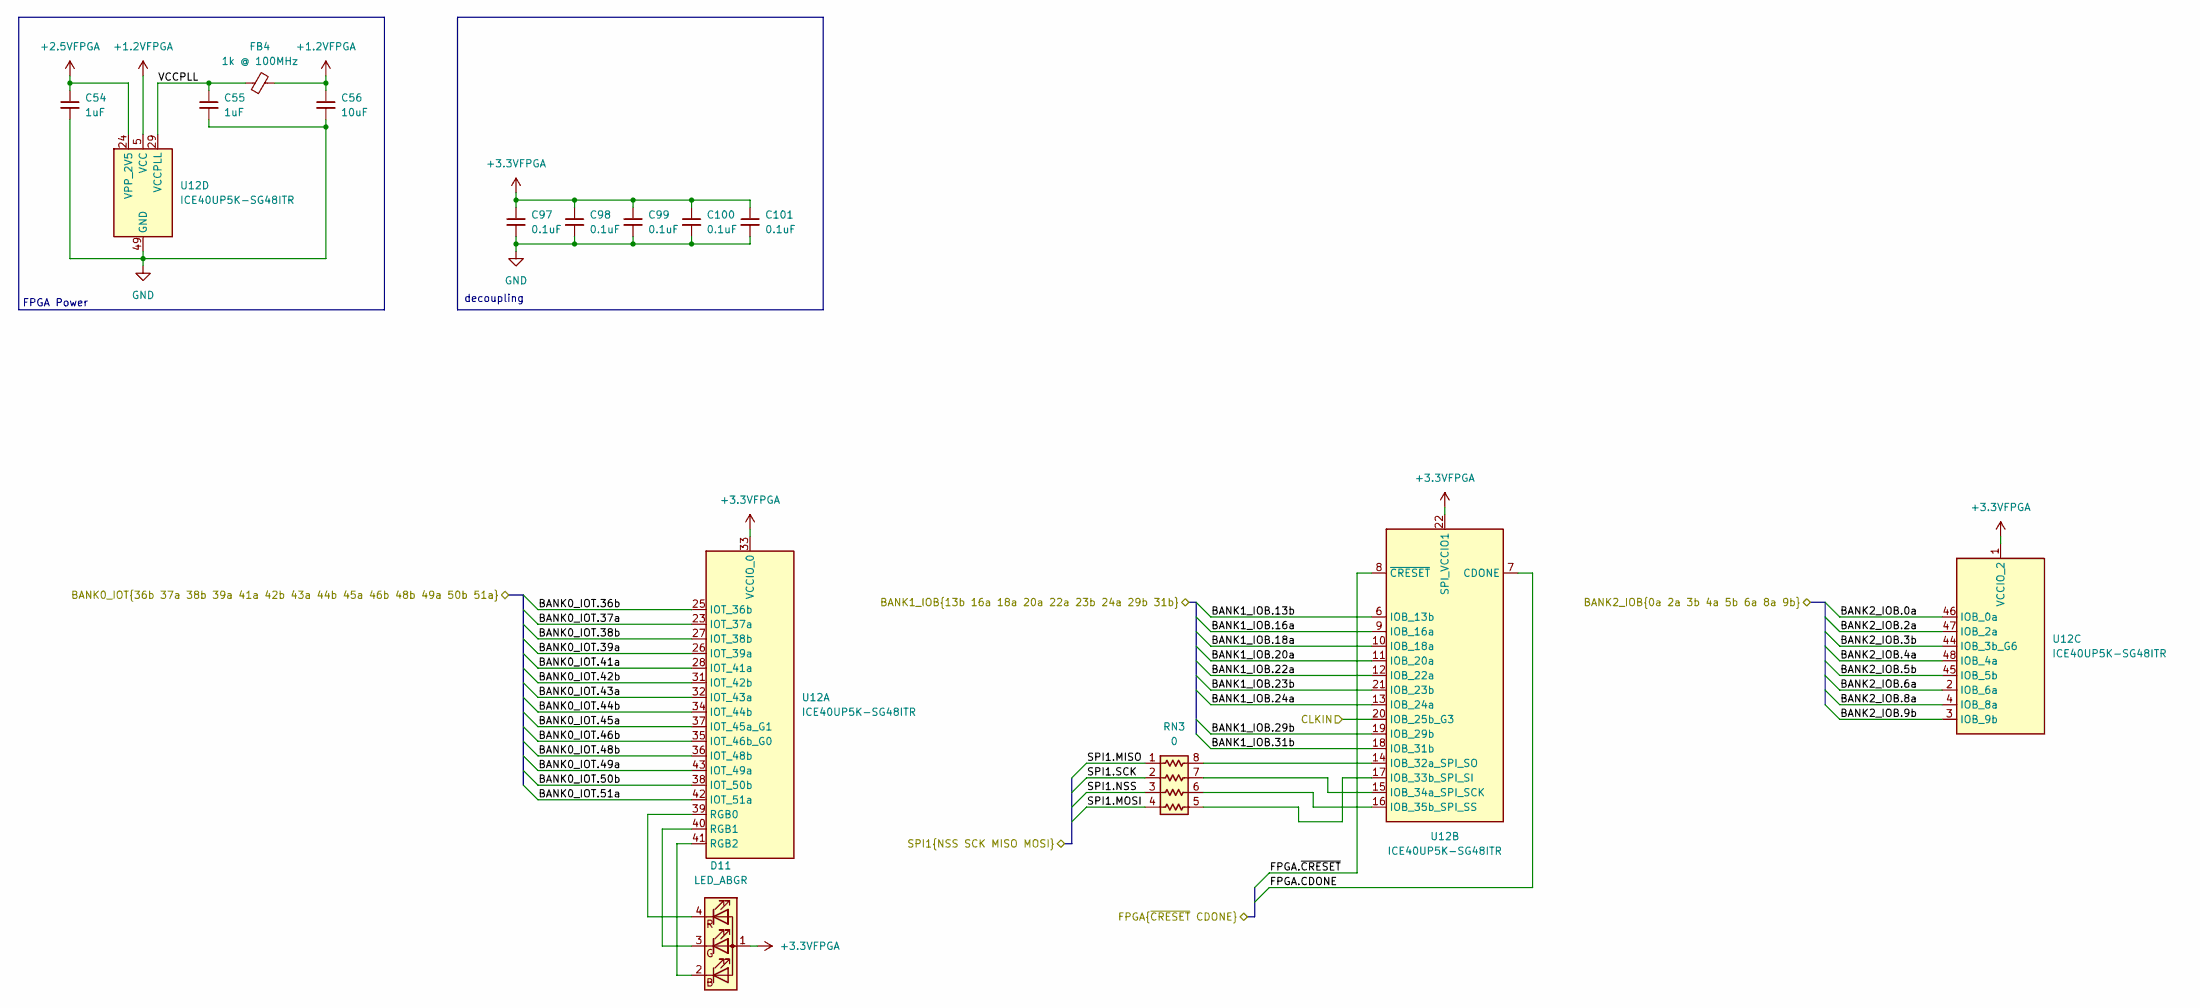
[picture p51: schematic fpga.kicad_sch]

Parts:
C54, C55: 1uF; C_0603_1608Metric
C56: 10uF; C_0603_1608Metric
C97, C98, C99, C100, C101: 0.1uF; C_0603_1608Metric
D11: LED_ABGR; LED_Cree-PLCC4_2x2mm_CW; LCSC C5620247
FB4: 1k @ 100MHz; Ferrite_0603_1608Metric
RN3: 0; R_Array_Concave_4x0603
U12: ICE40UP5K-SG48ITR; QFN-48-1EP_7x7mm_P0.5mm_EP5.6x5.6mm

Connections:
+1.2VFPGA: C56.1, FB4.2, U12.5 (VCC), U12.30 (VCC); also elsewhere on the board
+2.5VFPGA: C54.1, U12.24 (VPP_2V5); also elsewhere on the board
+3.3VFPGA: C97.1, C98.1, C99.1, C100.1, C101.1, D11.1 (A), U12.1 (VCCIO_2), U12.22 (SPI_VCCIO1), U12.33 (VCCIO_0); also elsewhere on the board
/Clock/FPGA_CLK: U12.20 (IOB_25b_G3); also elsewhere on the board
/FPGA/BANK0_IOT.36b: U12.25 (IOT_36b); also elsewhere on the board
/FPGA/BANK0_IOT.37a: U12.23 (IOT_37a); also elsewhere on the board
/FPGA/BANK0_IOT.38b: U12.27 (IOT_38b); also elsewhere on the board
/FPGA/BANK0_IOT.39a: U12.26 (IOT_39a); also elsewhere on the board
/FPGA/BANK0_IOT.41a: U12.28 (IOT_41a); also elsewhere on the board
/FPGA/BANK0_IOT.42b: U12.31 (IOT_42b); also elsewhere on the board
/FPGA/BANK0_IOT.43a: U12.32 (IOT_43a); also elsewhere on the board
/FPGA/BANK0_IOT.44b: U12.34 (IOT_44b); also elsewhere on the board
/FPGA/BANK0_IOT.45a: U12.37 (IOT_45a_G1); also elsewhere on the board
/FPGA/BANK0_IOT.46b: U12.35 (IOT_46b_G0); also elsewhere on the board
/FPGA/BANK0_IOT.48b: U12.36 (IOT_48b); also elsewhere on the board
/FPGA/BANK0_IOT.49a: U12.43 (IOT_49a); also elsewhere on the board
/FPGA/BANK0_IOT.50b: U12.38 (IOT_50b); also elsewhere on the board
/FPGA/BANK0_IOT.51a: U12.42 (IOT_51a); also elsewhere on the board
/FPGA/BANK1_IOB.13b: U12.6 (IOB_13b); also elsewhere on the board
/FPGA/BANK1_IOB.16a: U12.9 (IOB_16a); also elsewhere on the board
/FPGA/BANK1_IOB.18a: U12.10 (IOB_18a); also elsewhere on the board
/FPGA/BANK1_IOB.20a: U12.11 (IOB_20a); also elsewhere on the board
/FPGA/BANK1_IOB.22a: U12.12 (IOB_22a); also elsewhere on the board
/FPGA/BANK1_IOB.23b: U12.21 (IOB_23b); also elsewhere on the board
/FPGA/BANK1_IOB.24a: U12.13 (IOB_24a); also elsewhere on the board
/FPGA/BANK1_IOB.29b: U12.19 (IOB_29b); also elsewhere on the board
/FPGA/BANK1_IOB.31b: U12.18 (IOB_31b); also elsewhere on the board
/FPGA/BANK2_IOB.0a: U12.46 (IOB_0a); also elsewhere on the board
/FPGA/BANK2_IOB.2a: U12.47 (IOB_2a); also elsewhere on the board
/FPGA/BANK2_IOB.3b: U12.44 (IOB_3b_G6); also elsewhere on the board
/FPGA/BANK2_IOB.4a: U12.48 (IOB_4a); also elsewhere on the board
/FPGA/BANK2_IOB.5b: U12.45 (IOB_5b); also elsewhere on the board
/FPGA/BANK2_IOB.6a: U12.2 (IOB_6a); also elsewhere on the board
/FPGA/BANK2_IOB.8a: U12.4 (IOB_8a); also elsewhere on the board
/FPGA/BANK2_IOB.9b: U12.3 (IOB_9b); also elsewhere on the board
/FPGA/FPGA.CDONE: U12.7 (CDONE); also elsewhere on the board
/FPGA/FPGA.~CRESET: U12.8 (~CRESET); also elsewhere on the board
/FPGA/SPI1.MISO: RN3.1 (R1.1); also elsewhere on the board
/FPGA/SPI1.MOSI: RN3.4 (R4.1); also elsewhere on the board
/FPGA/SPI1.NSS: RN3.3 (R3.1); also elsewhere on the board
/FPGA/SPI1.SCK: RN3.2 (R2.1); also elsewhere on the board
/FPGA/VCCPLL: C55.1, FB4.1, U12.29 (VCCPLL)
GND: C54.2, C55.2, C56.2, C97.2, C98.2, C99.2, C100.2, C101.2, U12.49 (GND); also elsewhere on the board
unnamed: D11.2 (BK), U12.41 (RGB2)
unnamed: D11.3 (GK), U12.40 (RGB1)
unnamed: D11.4 (RK), U12.39 (RGB0)
unnamed: RN3.8 (R1.2), U12.14 (IOB_32a_SPI_SO)
unnamed: RN3.7 (R2.2), U12.15 (IOB_34a_SPI_SCK)
unnamed: RN3.6 (R3.2), U12.16 (IOB_35b_SPI_SS)
unnamed: RN3.5 (R4.2), U12.17 (IOB_33b_SPI_SI)

Notes on the sheet:
decoupling
FPGA Power

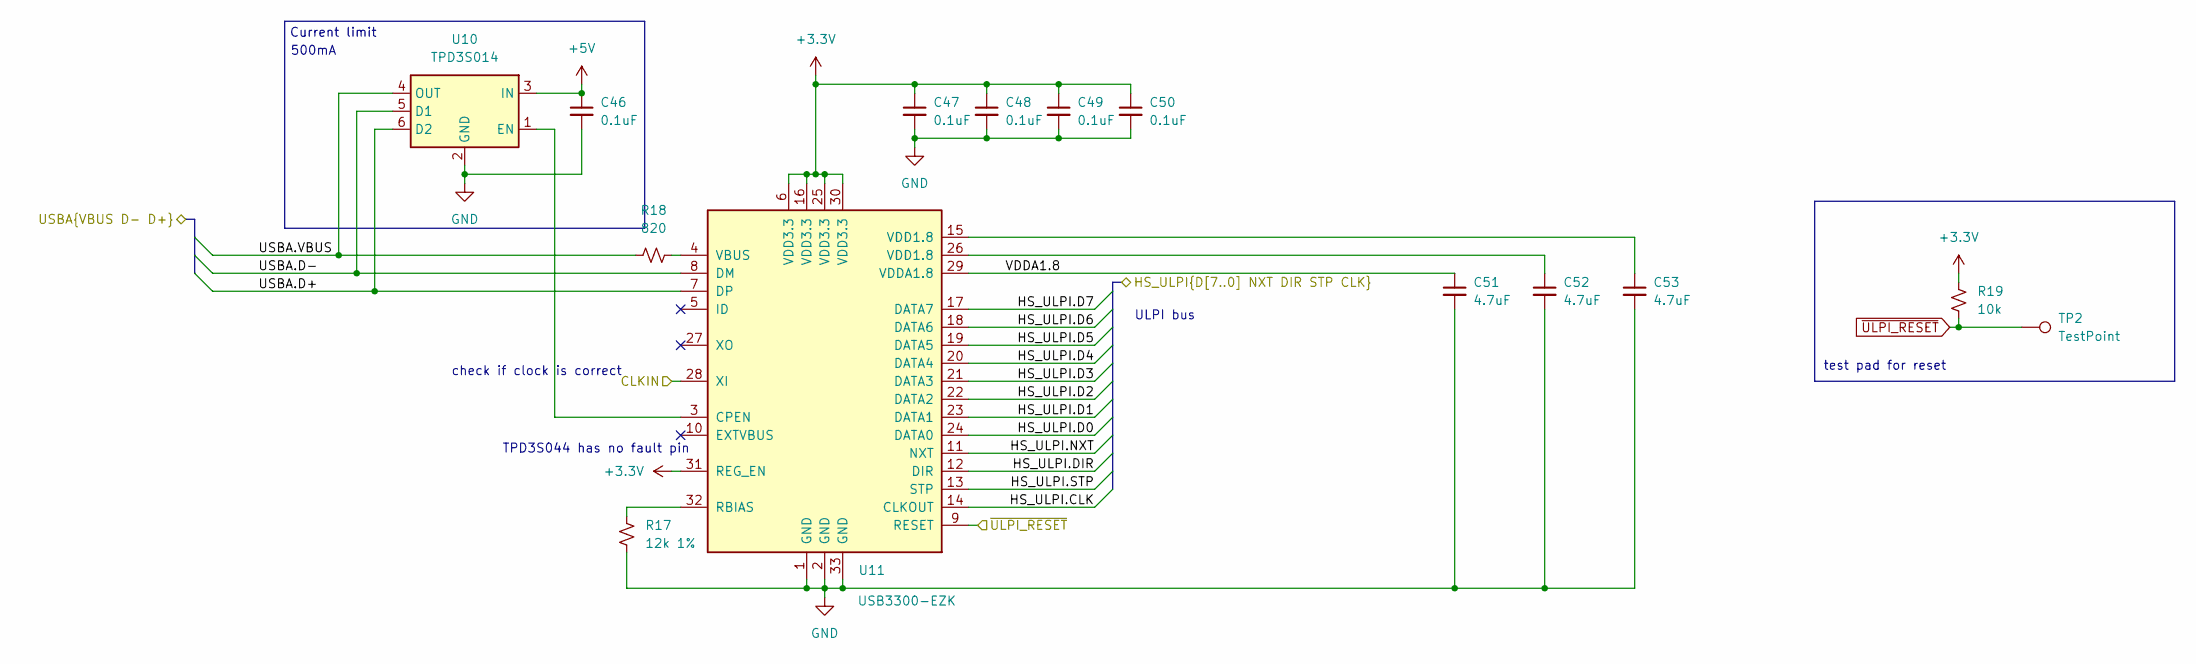
[picture p52: schematic ulpi.kicad_sch]

Parts:
C46, C47, C48, C49, C50: 0.1uF; C_0603_1608Metric
C51, C52, C53: 4.7uF; C_0603_1608Metric
R17: 12k 1%; R_0603_1608Metric
R18: 820; R_0603_1608Metric
R19: 10k; R_0603_1608Metric
TP2: TestPoint; TestPoint_Pad_D1.5mm
U10: TPD3S014; SOT-23-6
U11: USB3300-EZK; QFN-32-1EP_5x5mm_P0.5mm_EP3.45x3.45mm

Connections:
+3.3V: C47.1, C48.1, C49.1, C50.1, R19.1, U11.6 (VDD3.3), U11.16 (VDD3.3), U11.25 (VDD3.3), U11.30 (VDD3.3), U11.31 (REG_EN); also elsewhere on the board
+5V: C46.1, U10.3 (IN); also elsewhere on the board
/Clock/ULPI_CLK: U11.28 (XI); also elsewhere on the board
/MCU/HS_ULPI.CLK: U11.14 (CLKOUT); also elsewhere on the board
/MCU/HS_ULPI.D0: U11.24 (DATA0); also elsewhere on the board
/MCU/HS_ULPI.D1: U11.23 (DATA1); also elsewhere on the board
/MCU/HS_ULPI.D2: U11.22 (DATA2); also elsewhere on the board
/MCU/HS_ULPI.D3: U11.21 (DATA3); also elsewhere on the board
/MCU/HS_ULPI.D4: U11.20 (DATA4); also elsewhere on the board
/MCU/HS_ULPI.D5: U11.19 (DATA5); also elsewhere on the board
/MCU/HS_ULPI.D6: U11.18 (DATA6); also elsewhere on the board
/MCU/HS_ULPI.D7: U11.17 (DATA7); also elsewhere on the board
/MCU/HS_ULPI.DIR: U11.12 (DIR); also elsewhere on the board
/MCU/HS_ULPI.NXT: U11.11 (NXT); also elsewhere on the board
/MCU/HS_ULPI.STP: U11.13 (STP); also elsewhere on the board
/ULPI/USBA.D+: U10.6 (D2), U11.7 (DP); also elsewhere on the board
/ULPI/USBA.D-: U10.5 (D1), U11.8 (DM); also elsewhere on the board
/ULPI/USBA.VBUS: R18.1, U10.4 (OUT); also elsewhere on the board
/ULPI/VDDA1.8: C51.1, U11.29 (VDDA1.8)
GND: C46.2, C47.2, C48.2, C49.2, C50.2, C51.2, C52.2, C53.2, R17.2, U10.2 (GND), U11.1 (GND), U11.2 (GND), U11.33 (GND); also elsewhere on the board
unnamed: C52.1, U11.26 (VDD1.8)
unnamed: C53.1, U11.15 (VDD1.8)
unnamed: U10.1 (EN), U11.3 (CPEN)
unnamed: R17.1, U11.32 (RBIAS)
unnamed: R18.2, U11.4 (VBUS)
~ULPI_RESET: R19.2, TP2.1 (1_1), U11.9 (RESET); also elsewhere on the board

Notes on the sheet:
Current limit
TPD3S044 has no fault pin
test pad for reset
ULPI bus
500mA
check if clock is correct

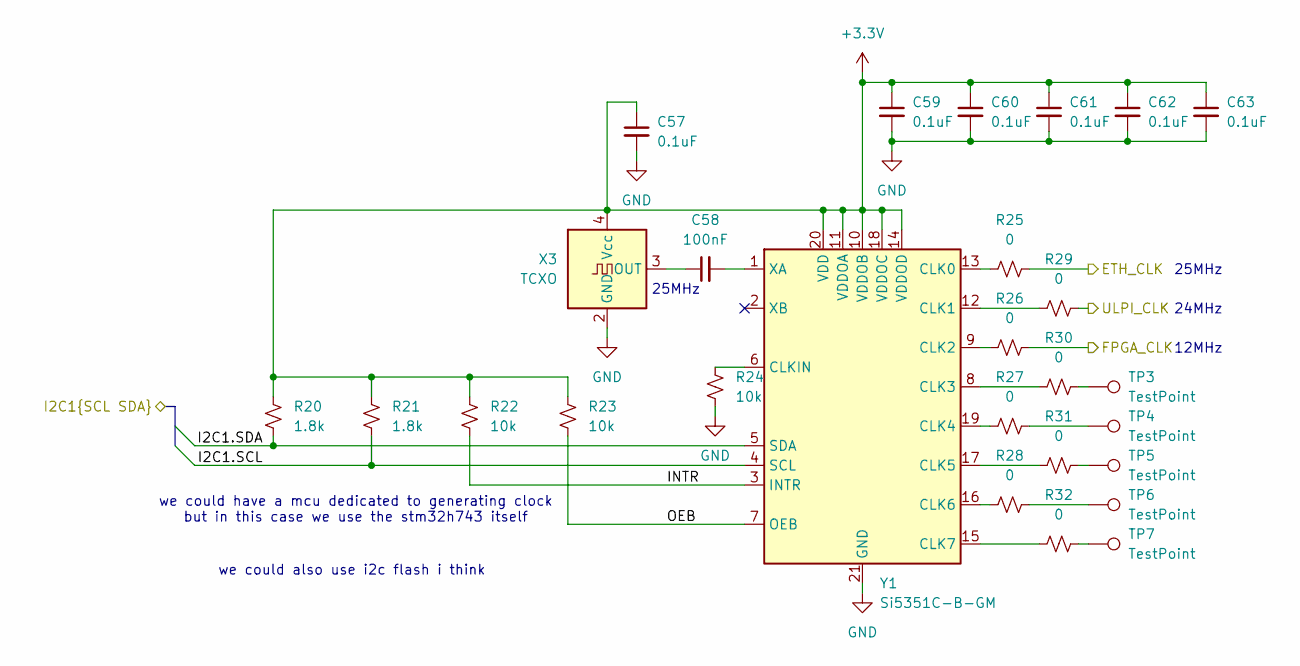
[picture p53: schematic clock.kicad_sch]

Parts:
C57, C59, C60, C61, C62, C63: 0.1uF; C_0603_1608Metric
C58: 100nF; C_0603_1608Metric
R20, R21: 1.8k; R_0603_1608Metric
R22, R23, R24: 10k; R_0603_1608Metric
R25, R26, R27, R28, R29, R30, R31, R32: 0; R_0603_1608Metric
TP3, TP4, TP5, TP6, TP7: TestPoint; TestPoint_Pad_D1.5mm
X3: TCXO; Oscillator_SMD_SeikoEpson_TG2520SMN-xxx-xxxxxx-4Pin_2.5x2.0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; Part Number 8122S-25.000NQ33FTL
Y1: Si5351C-B-GM; QFN-20-1EP_4x4mm_P0.5mm_EP2.7x2.7mm

Connections:
+3.3V: C57.1, C59.1, C60.1, C61.1, C62.1, C63.1, R20.1, R21.1, R22.1, R23.1, X3.4 (Vcc), Y1.10 (VDDOB), Y1.11 (VDDOA), Y1.14 (VDDOD), Y1.18 (VDDOC), Y1.20 (VDD); also elsewhere on the board
/Clock/ETH_CLK: R25.2; also elsewhere on the board
/Clock/FPGA_CLK: R26.2; also elsewhere on the board
/Clock/I2C1.SCL: R21.2, Y1.4 (SCL); also elsewhere on the board
/Clock/I2C1.SDA: R20.2, Y1.5 (SDA); also elsewhere on the board
/Clock/INTR: R22.2, Y1.3 (INTR)
/Clock/OEB: R23.2, Y1.7 (OEB)
/Clock/ULPI_CLK: R29.2; also elsewhere on the board
GND: C57.2, C59.2, C60.2, C61.2, C62.2, C63.2, R24.2, X3.2 (GND), Y1.21 (GND); also elsewhere on the board
unnamed: R27.2, TP4.1 (1_1)
unnamed: R28.2, TP6.1 (1_1)
unnamed: R30.2, TP3.1 (1_1)
unnamed: R31.2, TP5.1 (1_1)
unnamed: R32.2, TP7.1 (1_1)
unnamed: C58.1, X3.3 (OUT)
unnamed: R25.1, Y1.13 (CLK0)
unnamed: R29.1, Y1.12 (CLK1)
unnamed: R26.1, Y1.9 (CLK2)
unnamed: R30.1, Y1.8 (CLK3)
unnamed: R27.1, Y1.19 (CLK4)
unnamed: R31.1, Y1.17 (CLK5)
unnamed: R28.1, Y1.16 (CLK6)
unnamed: R32.1, Y1.15 (CLK7)
unnamed: R24.1, Y1.6 (CLKIN)
unnamed: C58.2, Y1.1 (XA)

Notes on the sheet:
25MHz
we could also use i2c flash i think
we could have a mcu dedicated to generating clock but in this case we use the stm32h743 itself
24MHz
12MHz
