sneakylizard123-4/STM32H743/kicad/STM32H743.kicad_pcb

## KiCad design kicad/STM32H743.kicad_pcb (continued)

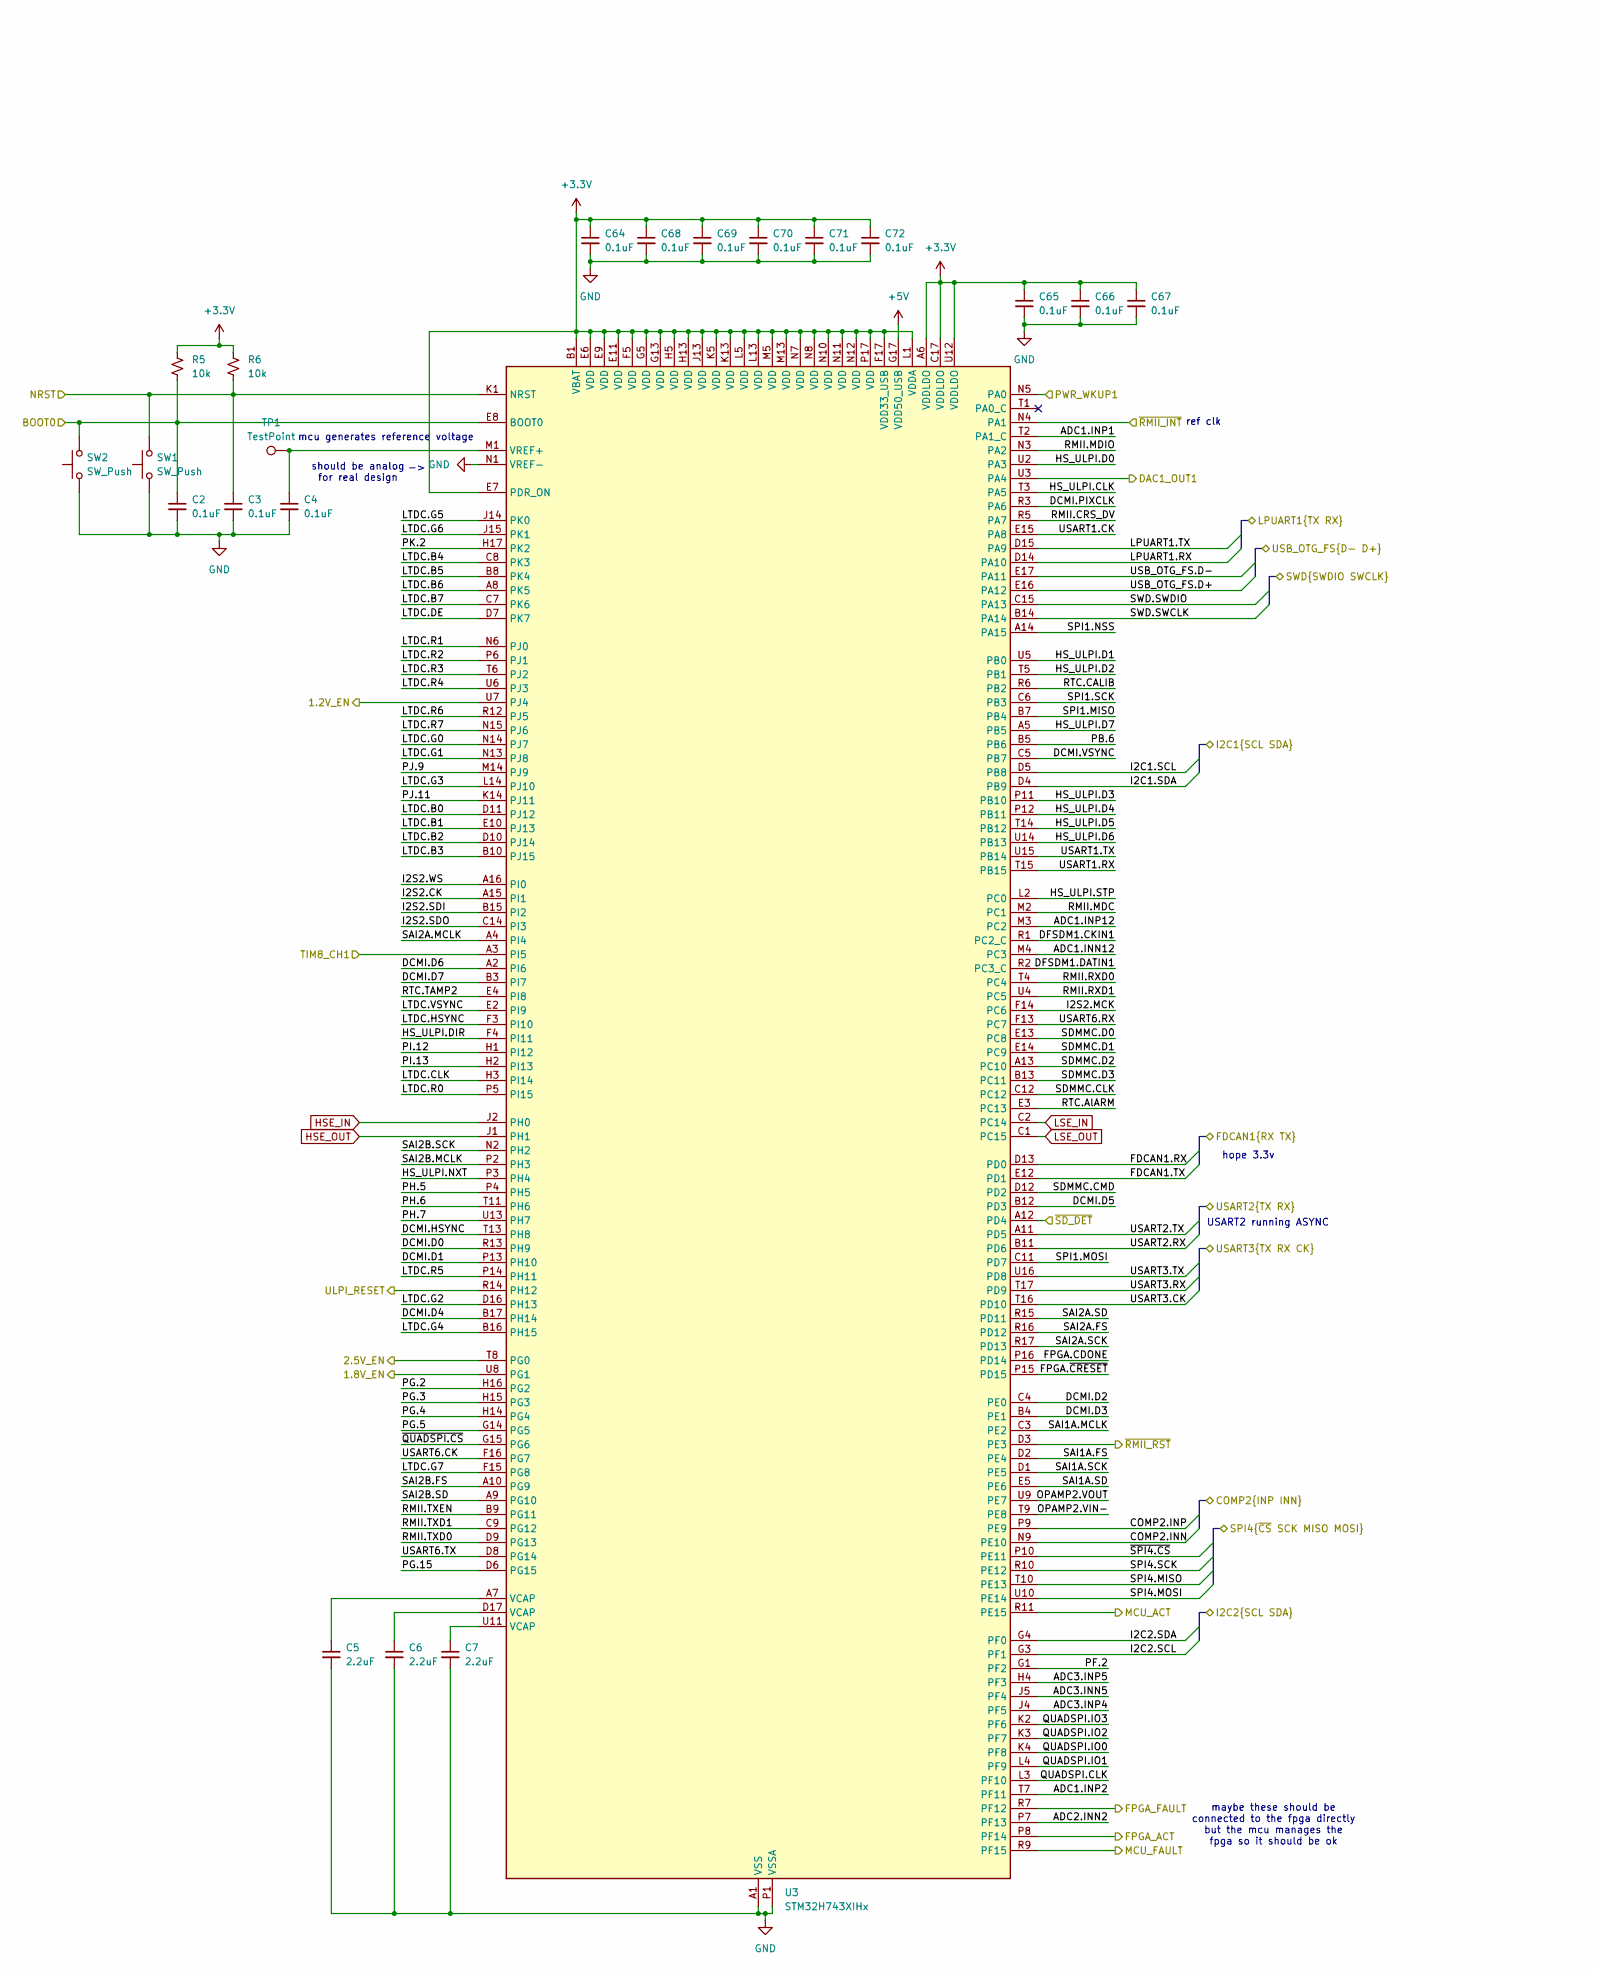
[picture p54: schematic mcu.kicad_sch, part in row 1, column 1]

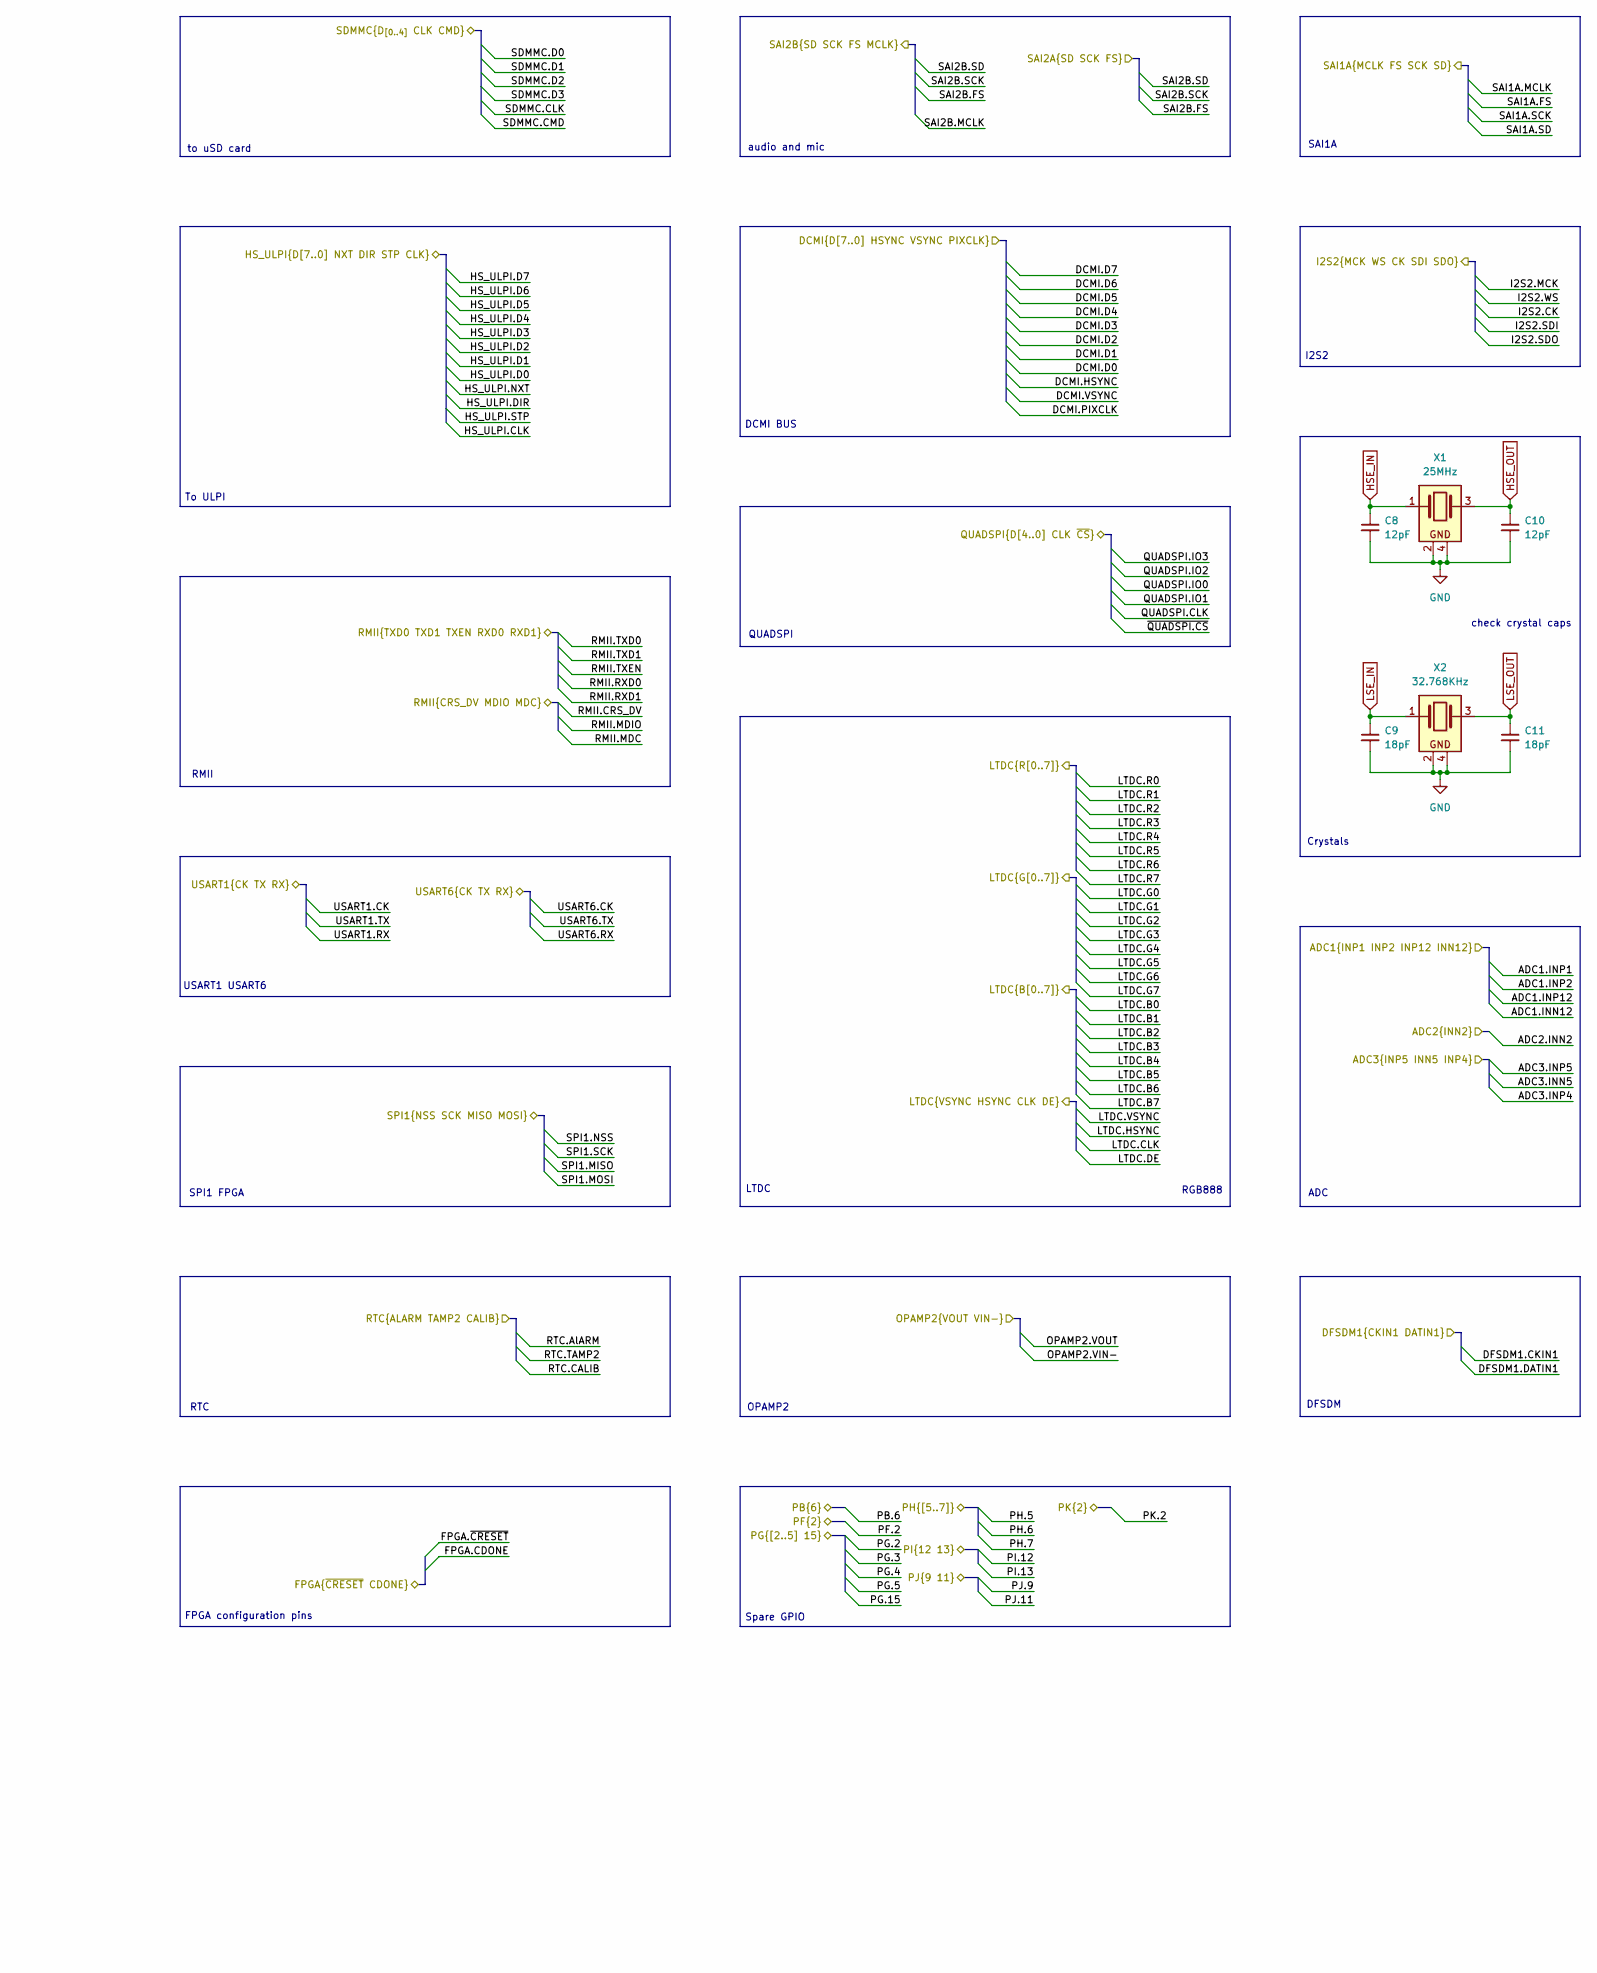
[picture p55: schematic mcu.kicad_sch, part in row 1, column 2]

Parts:
C2, C3, C4, C64, C65, C66, C67, C68, C69, C70, C71, C72: 0.1uF; C_0603_1608Metric
C5, C6, C7: 2.2uF; C_0603_1608Metric
C8, C10: 12pF; C_0603_1608Metric
C9, C11: 18pF; C_0603_1608Metric
R5, R6: 10k; R_0603_1608Metric
SW1, SW2: SW_Push; Panasonic_EVQPUM_EVQPUD
TP1: TestPoint; TestPoint_Pad_D1.5mm
U3: STM32H743XIHx; TFBGA-265_14x14mm_Layout17x17_P0.8mm
X1: 25MHz; Crystal_SMD_3225-4Pin_3.2x2.5mm
X2: 32.768KHz; Crystal_SMD_3225-4Pin_3.2x2.5mm

Connections:
+3.3V: C64.1, C65.1, C66.1, C67.1, C68.1, C69.1, C70.1, C71.1, C72.1, R5.1, R6.1, U3.A6 (VDDLDO), U3.B1 (VBAT), U3.C17 (VDDLDO), U3.E6 (VDD), U3.E7 (PDR_ON), U3.E9 (VDD), U3.E11 (VDD), U3.F5 (VDD), U3.F17 (VDD33_USB), U3.G5 (VDD), U3.G13 (VDD), U3.H5 (VDD), U3.H13 (VDD), U3.J13 (VDD), U3.K5 (VDD), U3.K13 (VDD), U3.L1 (VDDA), U3.L5 (VDD), U3.L13 (VDD), U3.M5 (VDD), U3.M13 (VDD), U3.N7 (VDD), U3.N8 (VDD), U3.N10 (VDD), U3.N11 (VDD), U3.N12 (VDD), U3.P17 (VDD), U3.U12 (VDDLDO); also elsewhere on the board
+5V: U3.G17 (VDD50_USB); also elsewhere on the board
/Audio/DFSDM1.CKIN1: U3.R1 (PC2_C); also elsewhere on the board
/Audio/DFSDM1.DATIN1: U3.R2 (PC3_C); also elsewhere on the board
/Audio/SAI2A.FS: U3.R16 (PD12); also elsewhere on the board
/Audio/SAI2A.SCK: U3.R17 (PD13); also elsewhere on the board
/Audio/SAI2A.SD: U3.R15 (PD11); also elsewhere on the board
/Audio/SAI2B.FS: U3.A10 (PG9); also elsewhere on the board
/Audio/SAI2B.MCLK: U3.P2 (PH3); also elsewhere on the board
/Audio/SAI2B.SCK: U3.N2 (PH2); also elsewhere on the board
/Audio/SAI2B.SD: U3.A9 (PG10); also elsewhere on the board
/Clock/I2C1.SCL: U3.D5 (PB8); also elsewhere on the board
/Clock/I2C1.SDA: U3.D4 (PB9); also elsewhere on the board
/Connector/ADC1.INN12: U3.M4 (PC3)
/Connector/ADC1.INP1: U3.T2 (PA1_C)
/Connector/ADC1.INP2: U3.T7 (PF11)
/Connector/ADC1.INP12: U3.M3 (PC2)
/Connector/ADC2.INN2: U3.P7 (PF13)
/Connector/ADC3.INN5: U3.J5 (PF4)
/Connector/ADC3.INP4: U3.J4 (PF5)
/Connector/ADC3.INP5: U3.H4 (PF3)
/Connector/BOOT0: C2.1, R5.2, SW2.2, U3.E8 (BOOT0)
/Connector/COMP2.INN: U3.N9 (PE10)
/Connector/COMP2.INP: U3.P9 (PE9)
/Connector/DAC1_OUT1: U3.U3 (PA4)
/Connector/DCMI.D0: U3.R13 (PH9)
/Connector/DCMI.D1: U3.P13 (PH10)
/Connector/DCMI.D2: U3.C4 (PE0)
/Connector/DCMI.D3: U3.B4 (PE1)
/Connector/DCMI.D4: U3.B17 (PH14)
/Connector/DCMI.D5: U3.B12 (PD3)
/Connector/DCMI.D6: U3.A2 (PI6)
/Connector/DCMI.D7: U3.B3 (PI7)
/Connector/DCMI.HSYNC: U3.T13 (PH8)
/Connector/DCMI.PIXCLK: U3.R3 (PA6)
/Connector/DCMI.VSYNC: U3.C5 (PB7)
/Connector/FDCAN1.RX: U3.D13 (PD0)
/Connector/FDCAN1.TX: U3.E12 (PD1)
/Connector/I2C2.SCL: U3.G3 (PF1)
/Connector/I2C2.SDA: U3.G4 (PF0)
/Connector/I2S2.CK: U3.A15 (PI1)
/Connector/I2S2.MCK: U3.F14 (PC6)
/Connector/I2S2.SDI: U3.B15 (PI2)
/Connector/I2S2.SDO: U3.C14 (PI3)
/Connector/I2S2.WS: U3.A16 (PI0)
/Connector/LPUART1.RX: U3.D14 (PA10)
/Connector/LPUART1.TX: U3.D15 (PA9)
/Connector/NRST: C3.1, R6.2, SW1.2, U3.K1 (NRST); also elsewhere on the board
/Connector/OPAMP2.VIN-: U3.T9 (PE8)
/Connector/OPAMP2.VOUT: U3.U9 (PE7)
/Connector/PWR_WKUP1: U3.N5 (PA0)
/Connector/QUADSPI.CLK: U3.L3 (PF10)
/Connector/RTC.CALIB: U3.R6 (PB2)
/Connector/RTC.TAMP2: U3.E4 (PI8)
/Connector/SAI1A.FS: U3.D2 (PE4)
/Connector/SAI1A.MCLK: U3.C3 (PE2)
/Connector/SAI1A.SCK: U3.D1 (PE5)
/Connector/SAI1A.SD: U3.E5 (PE6)
/Connector/SPI4.MISO: U3.T10 (PE13)
/Connector/SPI4.MOSI: U3.U10 (PE14)
/Connector/SPI4.SCK: U3.R10 (PE12)
/Connector/TIM8_CH1: U3.A3 (PI5)
/Connector/USART1.CK: U3.E15 (PA8)
/Connector/USART1.RX: U3.T15 (PB15)
/Connector/USART1.TX: U3.U15 (PB14)
/Connector/USART2.RX: U3.B11 (PD6)
/Connector/USART2.TX: U3.A11 (PD5)
/Connector/USART3.CK: U3.T16 (PD10)
/Connector/USART3.RX: U3.T17 (PD9)
/Connector/USART3.TX: U3.U16 (PD8)
/Connector/USART6.CK: U3.F16 (PG7)
/Connector/USART6.RX: U3.F13 (PC7)
/Connector/USART6.TX: U3.D8 (PG14)
/Ethernet/RMII.CRS_DV: U3.R5 (PA7); also elsewhere on the board
/Ethernet/RMII.MDC: U3.M2 (PC1); also elsewhere on the board
/Ethernet/RMII.MDIO: U3.N3 (PA2); also elsewhere on the board
/Ethernet/RMII.RXD0: U3.T4 (PC4); also elsewhere on the board
/Ethernet/RMII.RXD1: U3.U4 (PC5); also elsewhere on the board
/Ethernet/RMII.TXD0: U3.D9 (PG13); also elsewhere on the board
/Ethernet/RMII.TXD1: U3.C9 (PG12); also elsewhere on the board
/Ethernet/RMII.TXEN: U3.B9 (PG11); also elsewhere on the board
/Ethernet/~RMII_INT: U3.N4 (PA1); also elsewhere on the board
/Ethernet/~RMII_RST: U3.D3 (PE3); also elsewhere on the board
/FPGA/FPGA.CDONE: U3.P16 (PD14); also elsewhere on the board
/FPGA/FPGA.~CRESET: U3.P15 (PD15); also elsewhere on the board
/FPGA/SPI1.MISO: U3.B7 (PB4); also elsewhere on the board
/FPGA/SPI1.MOSI: U3.C11 (PD7); also elsewhere on the board
/FPGA/SPI1.NSS: U3.A14 (PA15); also elsewhere on the board
/FPGA/SPI1.SCK: U3.C6 (PB3); also elsewhere on the board
/GPIO/PB.6: U3.B5 (PB6); also elsewhere on the board
/GPIO/PF.2: U3.G1 (PF2); also elsewhere on the board
/GPIO/PG.2: U3.H16 (PG2); also elsewhere on the board
/GPIO/PG.3: U3.H15 (PG3); also elsewhere on the board
/GPIO/PG.4: U3.H14 (PG4); also elsewhere on the board
/GPIO/PG.5: U3.G14 (PG5); also elsewhere on the board
/GPIO/PG.15: U3.D6 (PG15); also elsewhere on the board
/GPIO/PH.5: U3.P4 (PH5); also elsewhere on the board
/GPIO/PH.6: U3.T11 (PH6); also elsewhere on the board
/GPIO/PH.7: U3.U13 (PH7); also elsewhere on the board
/GPIO/PI.12: U3.H1 (PI12); also elsewhere on the board
/GPIO/PI.13: U3.H2 (PI13); also elsewhere on the board
/GPIO/PJ.9: U3.M14 (PJ9); also elsewhere on the board
/GPIO/PJ.11: U3.K14 (PJ11); also elsewhere on the board
/GPIO/PK.2: U3.H17 (PK2); also elsewhere on the board
/LEDs/FPGA_ACT: U3.P8 (PF14); also elsewhere on the board
/LEDs/FPGA_FAULT: U3.R7 (PF12); also elsewhere on the board
/LEDs/MCU_ACT: U3.R11 (PE15); also elsewhere on the board
/LEDs/MCU_FAULT: U3.R9 (PF15); also elsewhere on the board
/LTDC/LTDC.B0: U3.D11 (PJ12)
/LTDC/LTDC.B1: U3.E10 (PJ13)
/LTDC/LTDC.B2: U3.D10 (PJ14)
/LTDC/LTDC.B3: U3.B10 (PJ15)
/LTDC/LTDC.B4: U3.C8 (PK3)
/LTDC/LTDC.B5: U3.B8 (PK4)
/LTDC/LTDC.B6: U3.A8 (PK5)
/LTDC/LTDC.B7: U3.C7 (PK6)
/LTDC/LTDC.CLK: U3.H3 (PI14)
/LTDC/LTDC.DE: U3.D7 (PK7)
/LTDC/LTDC.G0: U3.N14 (PJ7)
/LTDC/LTDC.G1: U3.N13 (PJ8)
/LTDC/LTDC.G2: U3.D16 (PH13)
/LTDC/LTDC.G3: U3.L14 (PJ10)
/LTDC/LTDC.G4: U3.B16 (PH15)
/LTDC/LTDC.G5: U3.J14 (PK0)
/LTDC/LTDC.G6: U3.J15 (PK1)
/LTDC/LTDC.G7: U3.F15 (PG8)
/LTDC/LTDC.HSYNC: U3.F3 (PI10)
/LTDC/LTDC.R0: U3.P5 (PI15)
/LTDC/LTDC.R1: U3.N6 (PJ0)
/LTDC/LTDC.R2: U3.P6 (PJ1)
/LTDC/LTDC.R3: U3.T6 (PJ2)
/LTDC/LTDC.R4: U3.U6 (PJ3)
/LTDC/LTDC.R5: U3.P14 (PH11)
/LTDC/LTDC.R6: U3.R12 (PJ5)
/LTDC/LTDC.R7: U3.N15 (PJ6)
/LTDC/LTDC.VSYNC: U3.E2 (PI9)
/MCU/1.2V_EN: U3.U7 (PJ4); also elsewhere on the board
/MCU/1.8V_EN: U3.U8 (PG1); also elsewhere on the board
/MCU/2.5V_EN: U3.T8 (PG0); also elsewhere on the board
/MCU/HS_ULPI.CLK: U3.T3 (PA5); also elsewhere on the board
/MCU/HS_ULPI.D0: U3.U2 (PA3); also elsewhere on the board
/MCU/HS_ULPI.D1: U3.U5 (PB0); also elsewhere on the board
/MCU/HS_ULPI.D2: U3.T5 (PB1); also elsewhere on the board
/MCU/HS_ULPI.D3: U3.P11 (PB10); also elsewhere on the board
/MCU/HS_ULPI.D4: U3.P12 (PB11); also elsewhere on the board
/MCU/HS_ULPI.D5: U3.T14 (PB12); also elsewhere on the board
/MCU/HS_ULPI.D6: U3.U14 (PB13); also elsewhere on the board
/MCU/HS_ULPI.D7: U3.A5 (PB5); also elsewhere on the board
/MCU/HS_ULPI.DIR: U3.F4 (PI11); also elsewhere on the board
/MCU/HS_ULPI.NXT: U3.P3 (PH4); also elsewhere on the board
/MCU/HS_ULPI.STP: U3.L2 (PC0); also elsewhere on the board
/MCU/QUADSPI.IO0: U3.K4 (PF8)
/MCU/QUADSPI.IO1: U3.L4 (PF9)
/MCU/QUADSPI.IO2: U3.K3 (PF7)
/MCU/QUADSPI.IO3: U3.K2 (PF6)
/MCU/RTC.AlARM: U3.E3 (PC13)
/MCU/SAI2A.MCLK: U3.A4 (PI4)
/MCU/USB_OTG_FS.D+: U3.E16 (PA12); also elsewhere on the board
/MCU/USB_OTG_FS.D-: U3.E17 (PA11); also elsewhere on the board
/MCU/~QUADSPI.CS: U3.G15 (PG6)
/MCU/~SD_DET: U3.A12 (PD4); also elsewhere on the board
/MCU/~SPI4.CS: U3.P10 (PE11)
GND: C2.2, C3.2, C4.2, C5.2, C6.2, C7.2, C8.2, C9.2, C10.2, C11.2, C64.2, C65.2, C66.2, C67.2, C68.2, C69.2, C70.2, C71.2, C72.2, SW1.1, SW2.1, U3.A1 (VSS), U3.A17 (VSS), U3.B2 (VSS), U3.B6 (VSS), U3.C10 (VSS), U3.C13 (VSS), U3.C16 (VSS), U3.F1 (VSS), U3.F2 (VSS), U3.G2 (VSS), U3.G7 (VSS), U3.G8 (VSS), U3.G9 (VSS), U3.G10 (VSS), U3.G11 (VSS), U3.G16 (VSS), U3.H7 (VSS), U3.H8 (VSS), U3.H9 (VSS), U3.H10 (VSS), U3.H11 (VSS), U3.J3 (VSS), U3.J7 (VSS), U3.J8 (VSS), U3.J9 (VSS), U3.J10 (VSS), U3.J11 (VSS), U3.J16 (VSS), U3.J17 (VSS), U3.K7 (VSS), U3.K8 (VSS), U3.K9 (VSS), U3.K10 (VSS), U3.K11 (VSS), U3.K15 (VSS), U3.L7 (VSS), U3.L8 (VSS), U3.L9 (VSS), U3.L10 (VSS), U3.L11 (VSS), U3.L15 (VSS), U3.M15 (VSS), U3.N1 (VREF-), U3.N16 (VSS), U3.P1 (VSSA), U3.R4 (VSS), U3.R8 (VSS), U3.T12 (VSS), U3.U1 (VSS), U3.U17 (VSS), X1.2, X1.4, X2.2, X2.4; also elsewhere on the board
HSE_IN: C8.1, U3.J2 (PH0), X1.1
HSE_OUT: C10.1, U3.J1 (PH1), X1.3
LSE_IN: C9.1, U3.C2 (PC14), X2.1
LSE_OUT: C11.1, U3.C1 (PC15), X2.3
unnamed: C5.1, U3.A7 (VCAP)
unnamed: C6.1, U3.D17 (VCAP)
unnamed: C7.1, U3.U11 (VCAP)
unnamed: C4.1, TP1.1 (1_1), U3.M1 (VREF+)
SD_CLK: U3.C12; also elsewhere on the board
SD_CMD: U3.D12 (PD2); also elsewhere on the board
SD_DAT0: U3.E13 (PC8); also elsewhere on the board
SD_DAT1: U3.E14 (PC9); also elsewhere on the board
SD_DAT2: U3.A13 (PC10); also elsewhere on the board
SD_DAT3: U3.B13 (PC11); also elsewhere on the board
SWCLK: U3.B14 (PA14); also elsewhere on the board
SWDIO: U3.C15 (PA13); also elsewhere on the board
~ULPI_RESET: U3.R14 (PH12); also elsewhere on the board

Notes on the sheet:
RGB888
SAI1A
USART2 running ASYNC
mcu generates reference voltage
Spare GPIO
OPAMP2
I2S2
To ULPI
audio and mic
ADC
DCMI BUS
maybe these should be connected to the fpga directly but the mcu manages the fpga so it should be ok
check crystal caps
RMII
SPI1 FPGA
LTDC
to uSD card
FPGA configuration pins
USART1 USART6
QUADSPI
RTC
should be analog for real design
hope 3.3v
ref clk
DFSDM
Crystals

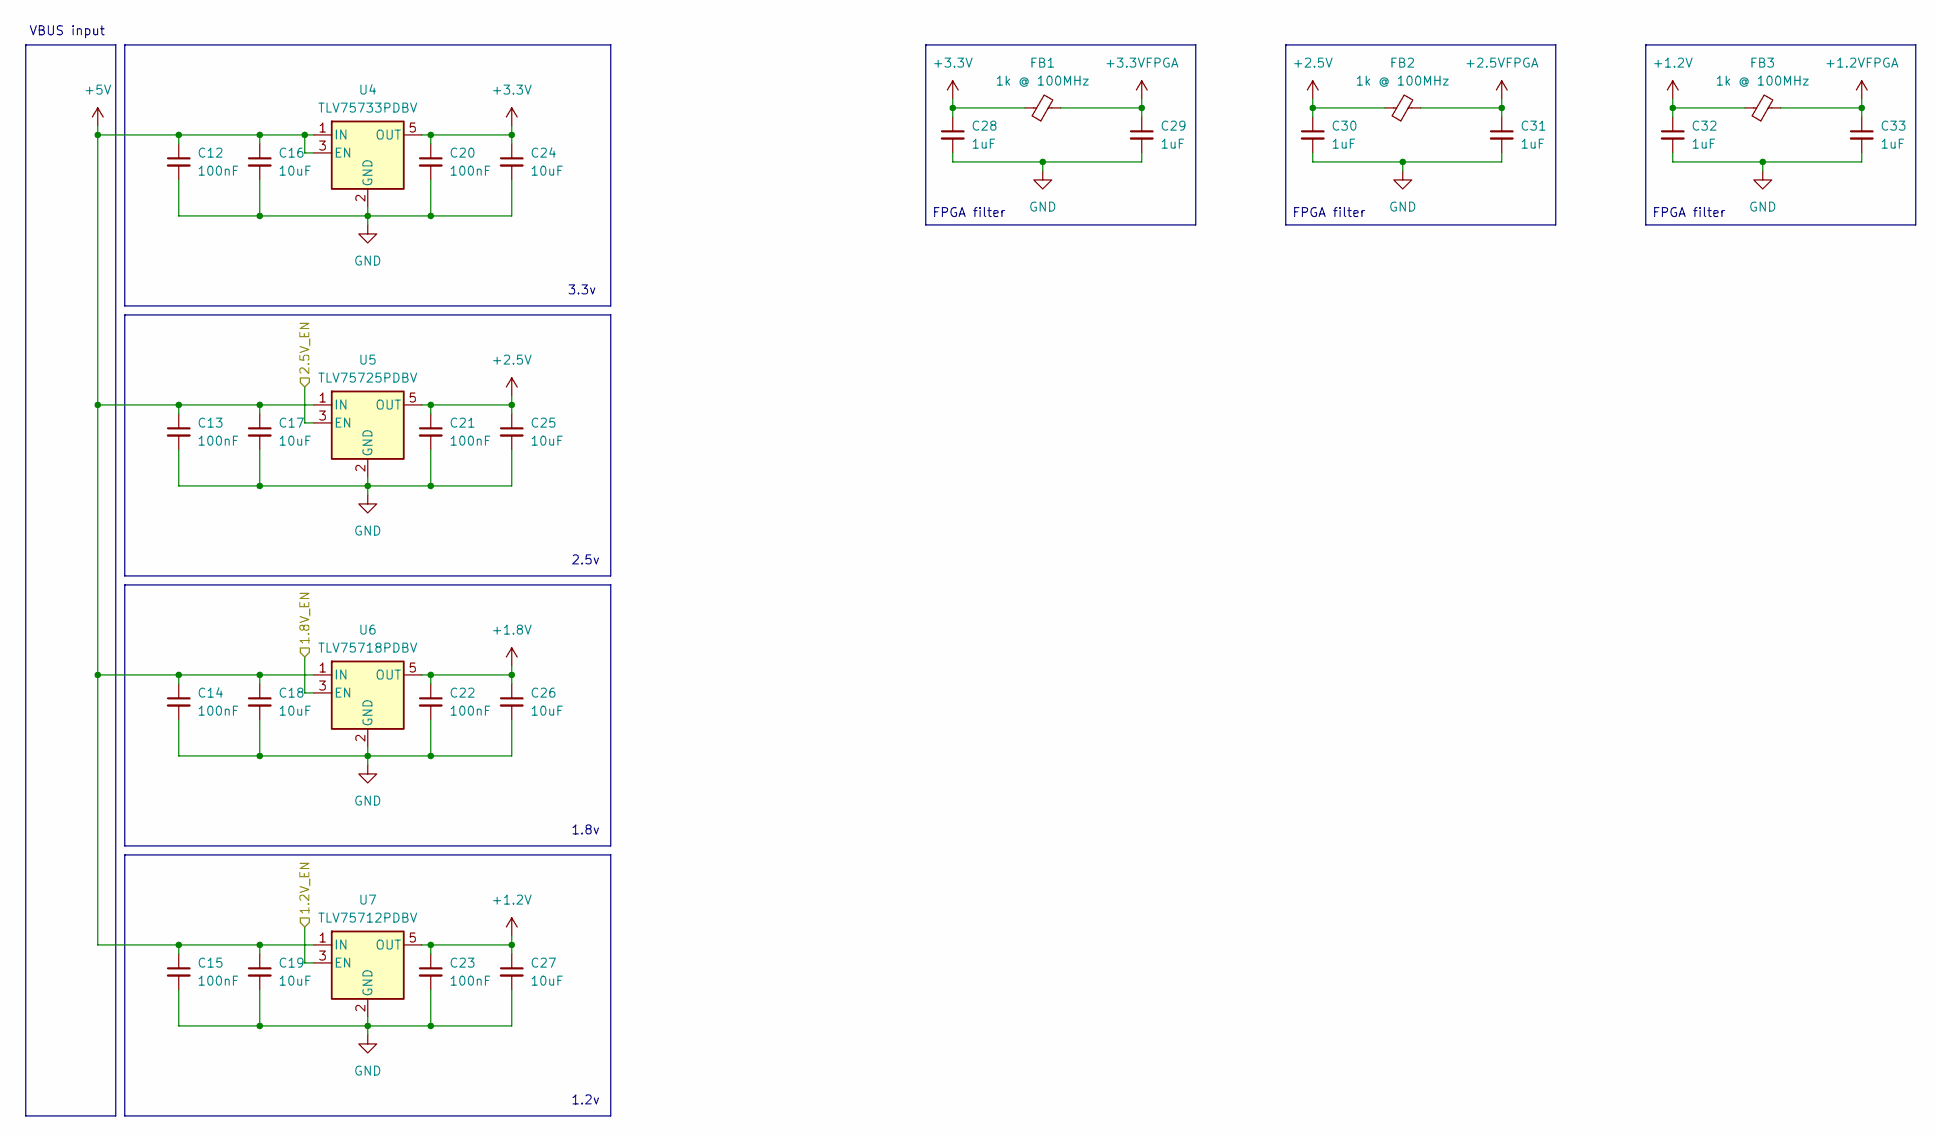
[picture p56: schematic power.kicad_sch]

Parts:
C12, C13, C14, C15, C20, C21, C22, C23: 100nF; C_0603_1608Metric
C16, C17, C18, C19, C24, C25, C26, C27: 10uF; C_0603_1608Metric
C28, C29, C30, C31, C32, C33: 1uF; C_0603_1608Metric
FB1, FB2, FB3: 1k @ 100MHz; Ferrite_0603_1608Metric
U4: TLV75733PDBV; SOT-23-5
U5: TLV75725PDBV; SOT-23-5
U6: TLV75718PDBV; SOT-23-5
U7: TLV75712PDBV; SOT-23-5

Connections:
+1.2V: C23.1, C27.1, C32.1, FB3.1, U7.5 (OUT); also elsewhere on the board
+1.2VFPGA: C33.1, FB3.2; also elsewhere on the board
+1.8V: C22.1, C26.1, U6.5 (OUT); also elsewhere on the board
+2.5V: C21.1, C25.1, C30.1, FB2.1, U5.5 (OUT); also elsewhere on the board
+2.5VFPGA: C31.1, FB2.2; also elsewhere on the board
+3.3V: C20.1, C24.1, C28.1, FB1.1, U4.5 (OUT); also elsewhere on the board
+3.3VFPGA: C29.1, FB1.2; also elsewhere on the board
+5V: C12.1, C13.1, C14.1, C15.1, C16.1, C17.1, C18.1, C19.1, U4.1 (IN), U4.3 (EN), U5.1 (IN), U6.1 (IN), U7.1 (IN); also elsewhere on the board
/MCU/1.2V_EN: U7.3 (EN); also elsewhere on the board
/MCU/1.8V_EN: U6.3 (EN); also elsewhere on the board
/MCU/2.5V_EN: U5.3 (EN); also elsewhere on the board
GND: C12.2, C13.2, C14.2, C15.2, C16.2, C17.2, C18.2, C19.2, C20.2, C21.2, C22.2, C23.2, C24.2, C25.2, C26.2, C27.2, C28.2, C29.2, C30.2, C31.2, C32.2, C33.2, U4.2 (GND), U5.2 (GND), U6.2 (GND), U7.2 (GND); also elsewhere on the board

Notes on the sheet:
1.8v
VBUS input
3.3v
FPGA filter
2.5v
1.2v

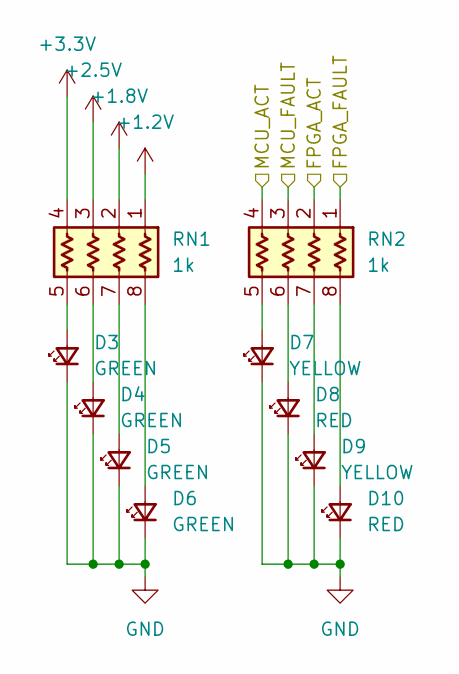
[picture p57: schematic leds.kicad_sch]

Parts:
D3, D4, D5, D6: GREEN; LED_0603_1608Metric
D7, D9: YELLOW; LED_0603_1608Metric
D8, D10: RED; LED_0603_1608Metric
RN1, RN2: 1k; R_Array_Concave_4x0603

Connections:
+1.2V: RN1.1 (R1.1); also elsewhere on the board
+1.8V: RN1.2 (R2.1); also elsewhere on the board
+2.5V: RN1.3 (R3.1); also elsewhere on the board
+3.3V: RN1.4 (R4.1); also elsewhere on the board
/LEDs/FPGA_ACT: RN2.2 (R2.1); also elsewhere on the board
/LEDs/FPGA_FAULT: RN2.1 (R1.1); also elsewhere on the board
/LEDs/MCU_ACT: RN2.4 (R4.1); also elsewhere on the board
/LEDs/MCU_FAULT: RN2.3 (R3.1); also elsewhere on the board
GND: D3.1 (K), D4.1 (K), D5.1 (K), D6.1 (K), D7.1 (K), D8.1 (K), D9.1 (K), D10.1 (K); also elsewhere on the board
unnamed: D3.2 (A), RN1.5 (R4.2)
unnamed: D4.2 (A), RN1.6 (R3.2)
unnamed: D5.2 (A), RN1.7 (R2.2)
unnamed: D6.2 (A), RN1.8 (R1.2)
unnamed: D7.2 (A), RN2.5 (R4.2)
unnamed: D8.2 (A), RN2.6 (R3.2)
unnamed: D9.2 (A), RN2.7 (R2.2)
unnamed: D10.2 (A), RN2.8 (R1.2)

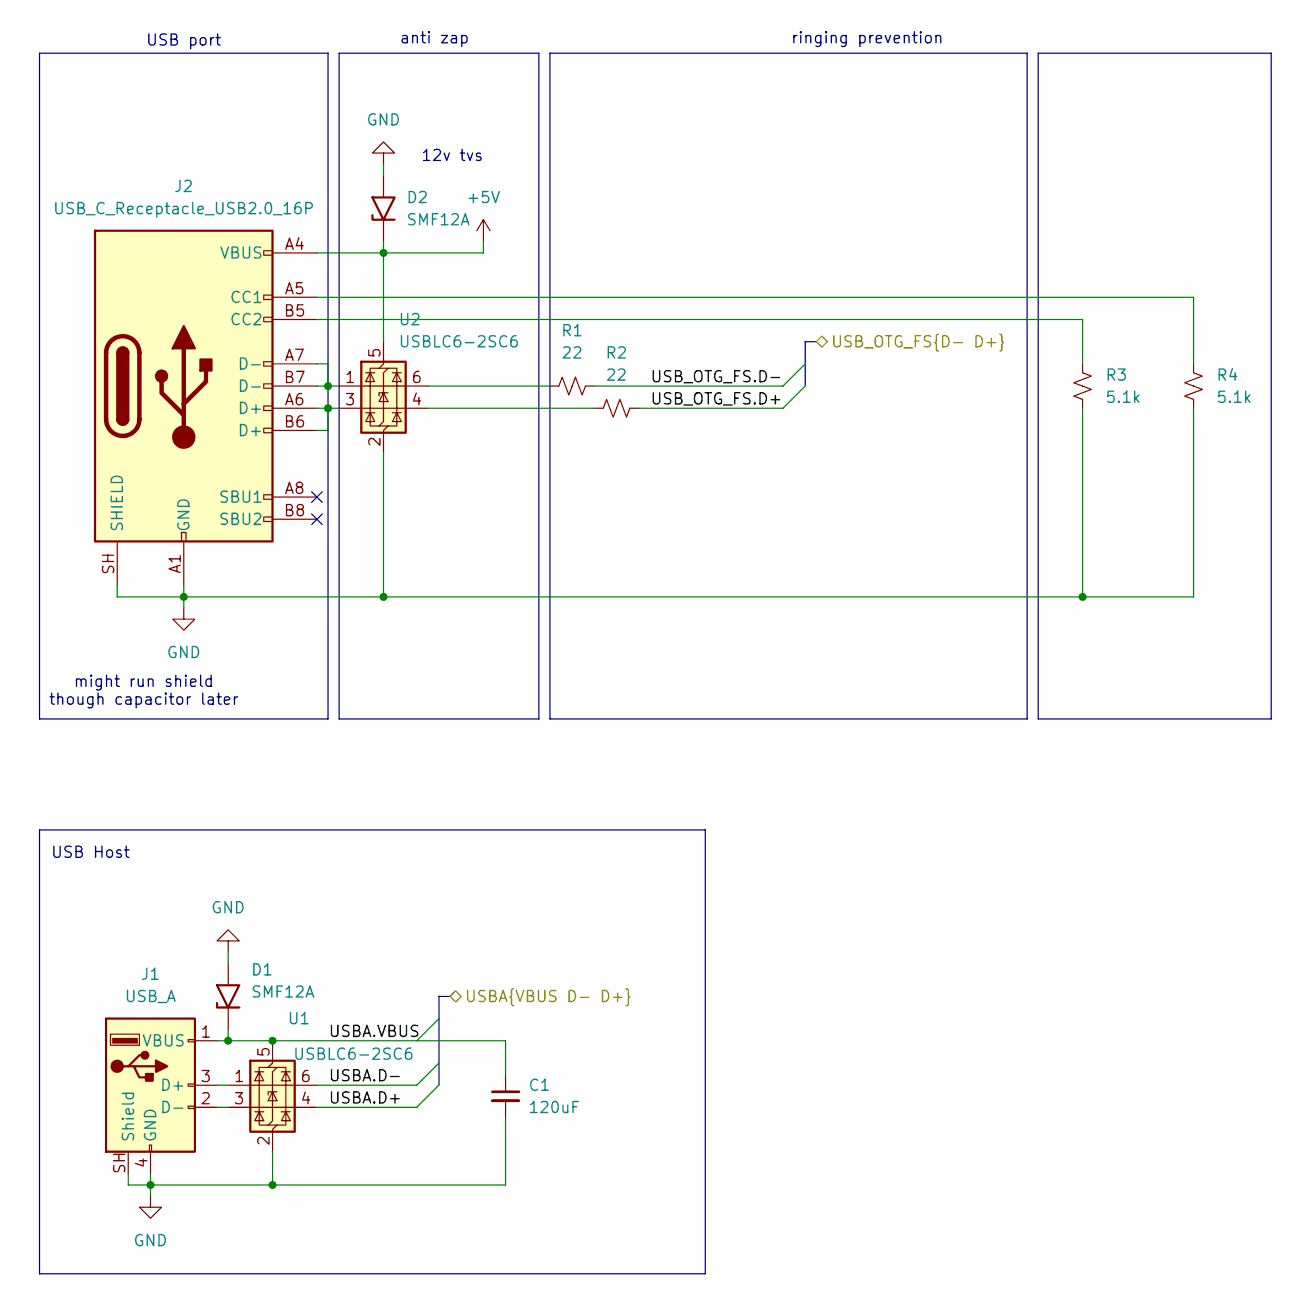
[picture p58: schematic usb.kicad_sch]

Parts:
C1: 120uF; C_0603_1608Metric
D1, D2: SMF12A; D_SMF
J1: USB_A; USB_A_Connfly_DS1095
J2: USB_C_Receptacle_USB2.0_16P; USB_C_Receptacle_HRO_TYPE-C-31-M-12
R1, R2: 22; R_0603_1608Metric
R3, R4: 5.1k; R_0603_1608Metric
U1, U2: USBLC6-2SC6; SOT-23-6

Connections:
+5V: D2.1 (A1), J2.A4 (VBUS), J2.A9 (VBUS), J2.B4 (VBUS), J2.B9 (VBUS), U2.5 (VBUS); also elsewhere on the board
/MCU/USB_OTG_FS.D+: R2.2; also elsewhere on the board
/MCU/USB_OTG_FS.D-: R1.2; also elsewhere on the board
/ULPI/USBA.D+: U1.4 (I/O2); also elsewhere on the board
/ULPI/USBA.D-: U1.6 (I/O1); also elsewhere on the board
/ULPI/USBA.VBUS: C1.1, D1.1 (A1), J1.1 (VBUS), U1.5 (VBUS); also elsewhere on the board
GND: C1.2, D1.2 (A2), D2.2 (A2), J1.4 (GND), J1.SH (Shield), J2.A1 (GND), J2.A12 (GND), J2.B1 (GND), J2.B12 (GND), J2.SH (SHIELD), R3.2, R4.2, U1.2 (GND), U2.2 (GND); also elsewhere on the board
unnamed: J1.3 (D+), U1.1 (I/O1)
unnamed: J1.2 (D-), U1.3 (I/O2)
unnamed: J2.A5 (CC1), R4.1
unnamed: J2.B5 (CC2), R3.1
unnamed: J2.A6 (D+), J2.B6 (D+), U2.3 (I/O2)
unnamed: J2.A7 (D-), J2.B7 (D-), U2.1 (I/O1)
unnamed: R1.1, U2.6 (I/O1)
unnamed: R2.1, U2.4 (I/O2)

Notes on the sheet:
anti zap
USB port
12v tvs
might run shield though capacitor later
USB Host
ringing prevention

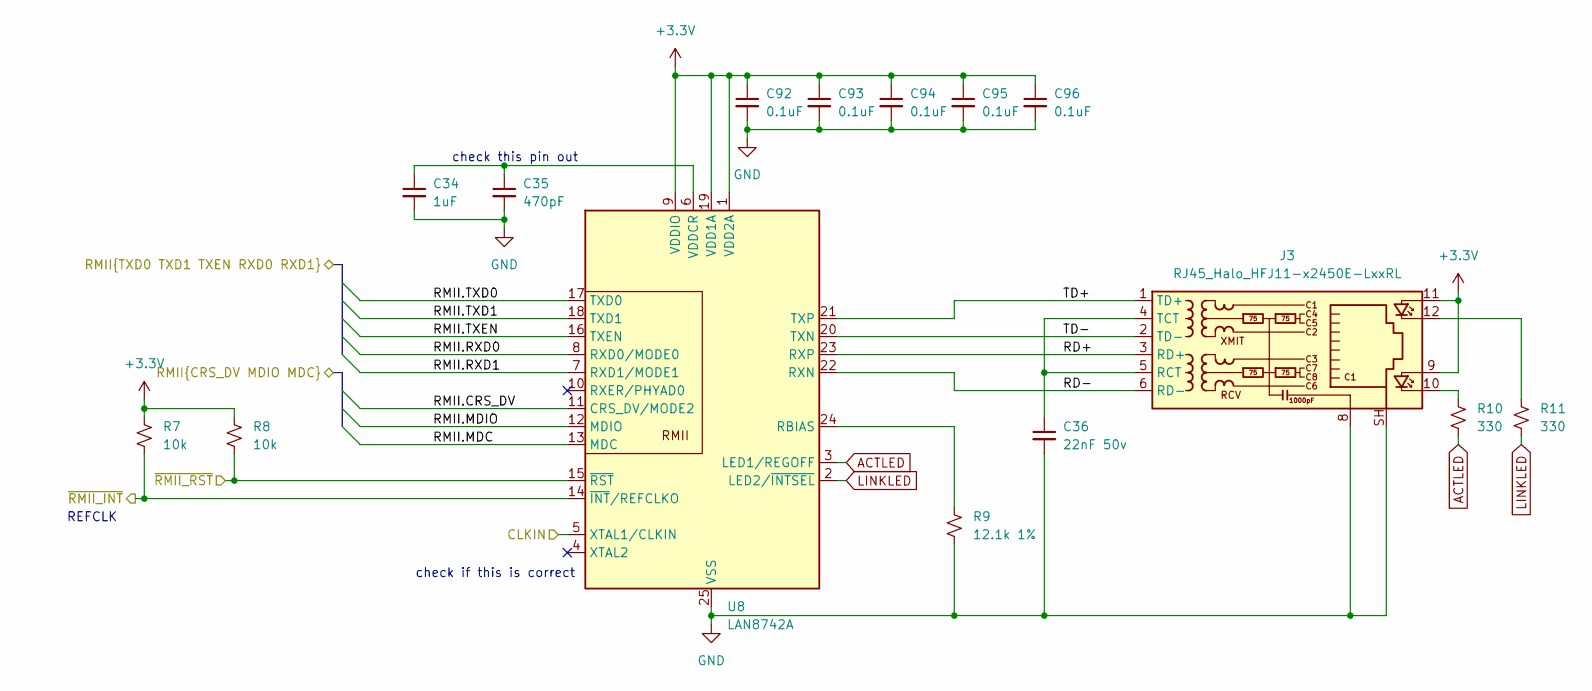
[picture p59: schematic ethernet.kicad_sch]

Parts:
C34: 1uF; C_0603_1608Metric
C35: 470pF; C_0603_1608Metric
C36: 22nF 50v; C_0603_1608Metric
C92, C93, C94, C95, C96: 0.1uF; C_0603_1608Metric
J3: RJ45_Halo_HFJ11-x2450E-LxxRL; RJ45_HALO_HFJ11-x2450E-LxxRL_Horizontal
R7, R8: 10k; R_0603_1608Metric
R9: 12.1k 1%; R_0603_1608Metric
R10, R11: 330; R_0603_1608Metric
U8: LAN8742A; VQFN-24-1EP_4x4mm_P0.5mm_EP2.5x2.5mm_ThermalVias

Connections:
+3.3V: C92.1, C93.1, C94.1, C95.1, C96.1, J3.9, J3.11, R7.1, R8.1, U8.1 (VDD2A), U8.9 (VDDIO), U8.19 (VDD1A); also elsewhere on the board
/Clock/ETH_CLK: U8.5 (XTAL1/CLKIN); also elsewhere on the board
/Ethernet/RD+: J3.3 (RD+), U8.23 (RXP)
/Ethernet/RD-: J3.6 (RD-), U8.22 (RXN)
/Ethernet/RMII.CRS_DV: U8.11 (CRS_DV/MODE2); also elsewhere on the board
/Ethernet/RMII.MDC: U8.13 (MDC); also elsewhere on the board
/Ethernet/RMII.MDIO: U8.12 (MDIO); also elsewhere on the board
/Ethernet/RMII.RXD0: U8.8 (RXD0/MODE0); also elsewhere on the board
/Ethernet/RMII.RXD1: U8.7 (RXD1/MODE1); also elsewhere on the board
/Ethernet/RMII.TXD0: U8.17 (TXD0); also elsewhere on the board
/Ethernet/RMII.TXD1: U8.18 (TXD1); also elsewhere on the board
/Ethernet/RMII.TXEN: U8.16 (TXEN); also elsewhere on the board
/Ethernet/TD+: J3.1 (TD+), U8.21 (TXP)
/Ethernet/TD-: J3.2 (TD-), U8.20 (TXN)
/Ethernet/~RMII_INT: R7.2, U8.14 (~INT/REFCLKO); also elsewhere on the board
/Ethernet/~RMII_RST: R8.2, U8.15 (~RST); also elsewhere on the board
ACTLED: R10.1, U8.3 (LED1/REGOFF)
GND: C34.2, C35.2, C36.2, C92.2, C93.2, C94.2, C95.2, C96.2, J3.8, J3.SH, R9.2, U8.25 (VSS); also elsewhere on the board
LINKLED: R11.1, U8.2 (LED2/~INTSEL)
unnamed: J3.10, R10.2
unnamed: J3.12, R11.2
unnamed: C36.1, J3.4 (TCT), J3.5 (RCT)
unnamed: R9.1, U8.24 (RBIAS)
unnamed: C34.1, C35.1, U8.6 (VDDCR)

Notes on the sheet:
check if this is correct
check this pin out
REFCLK
