sneakylizard123-4/STM32H743/kicad/STM32H743.kicad_pcb

## KiCad design kicad/STM32H743.kicad_pcb (continued)

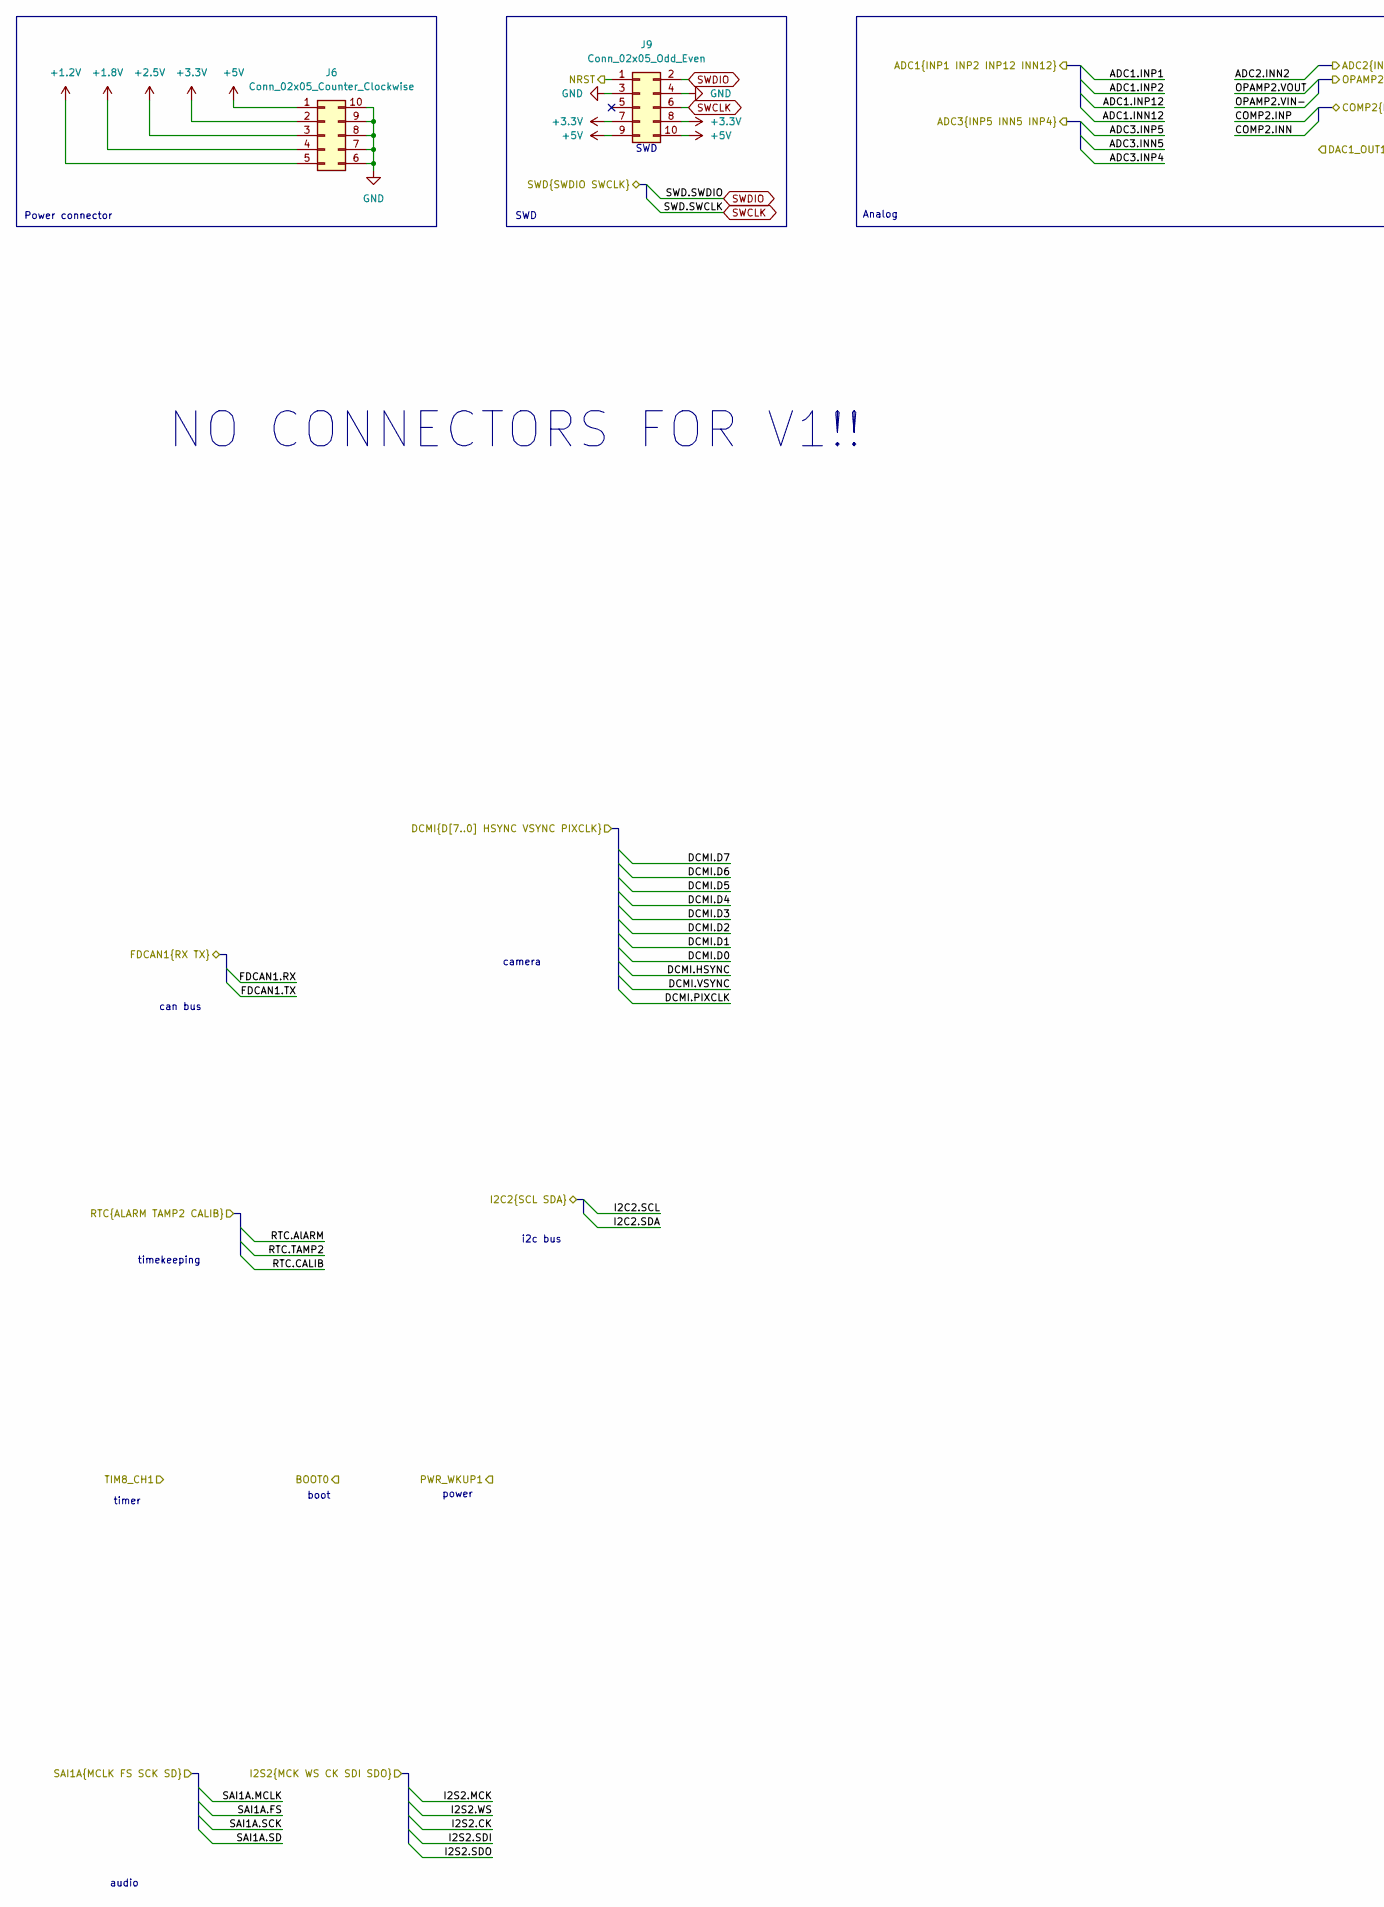
[picture p60: schematic connector.kicad_sch, part in row 1, column 1]

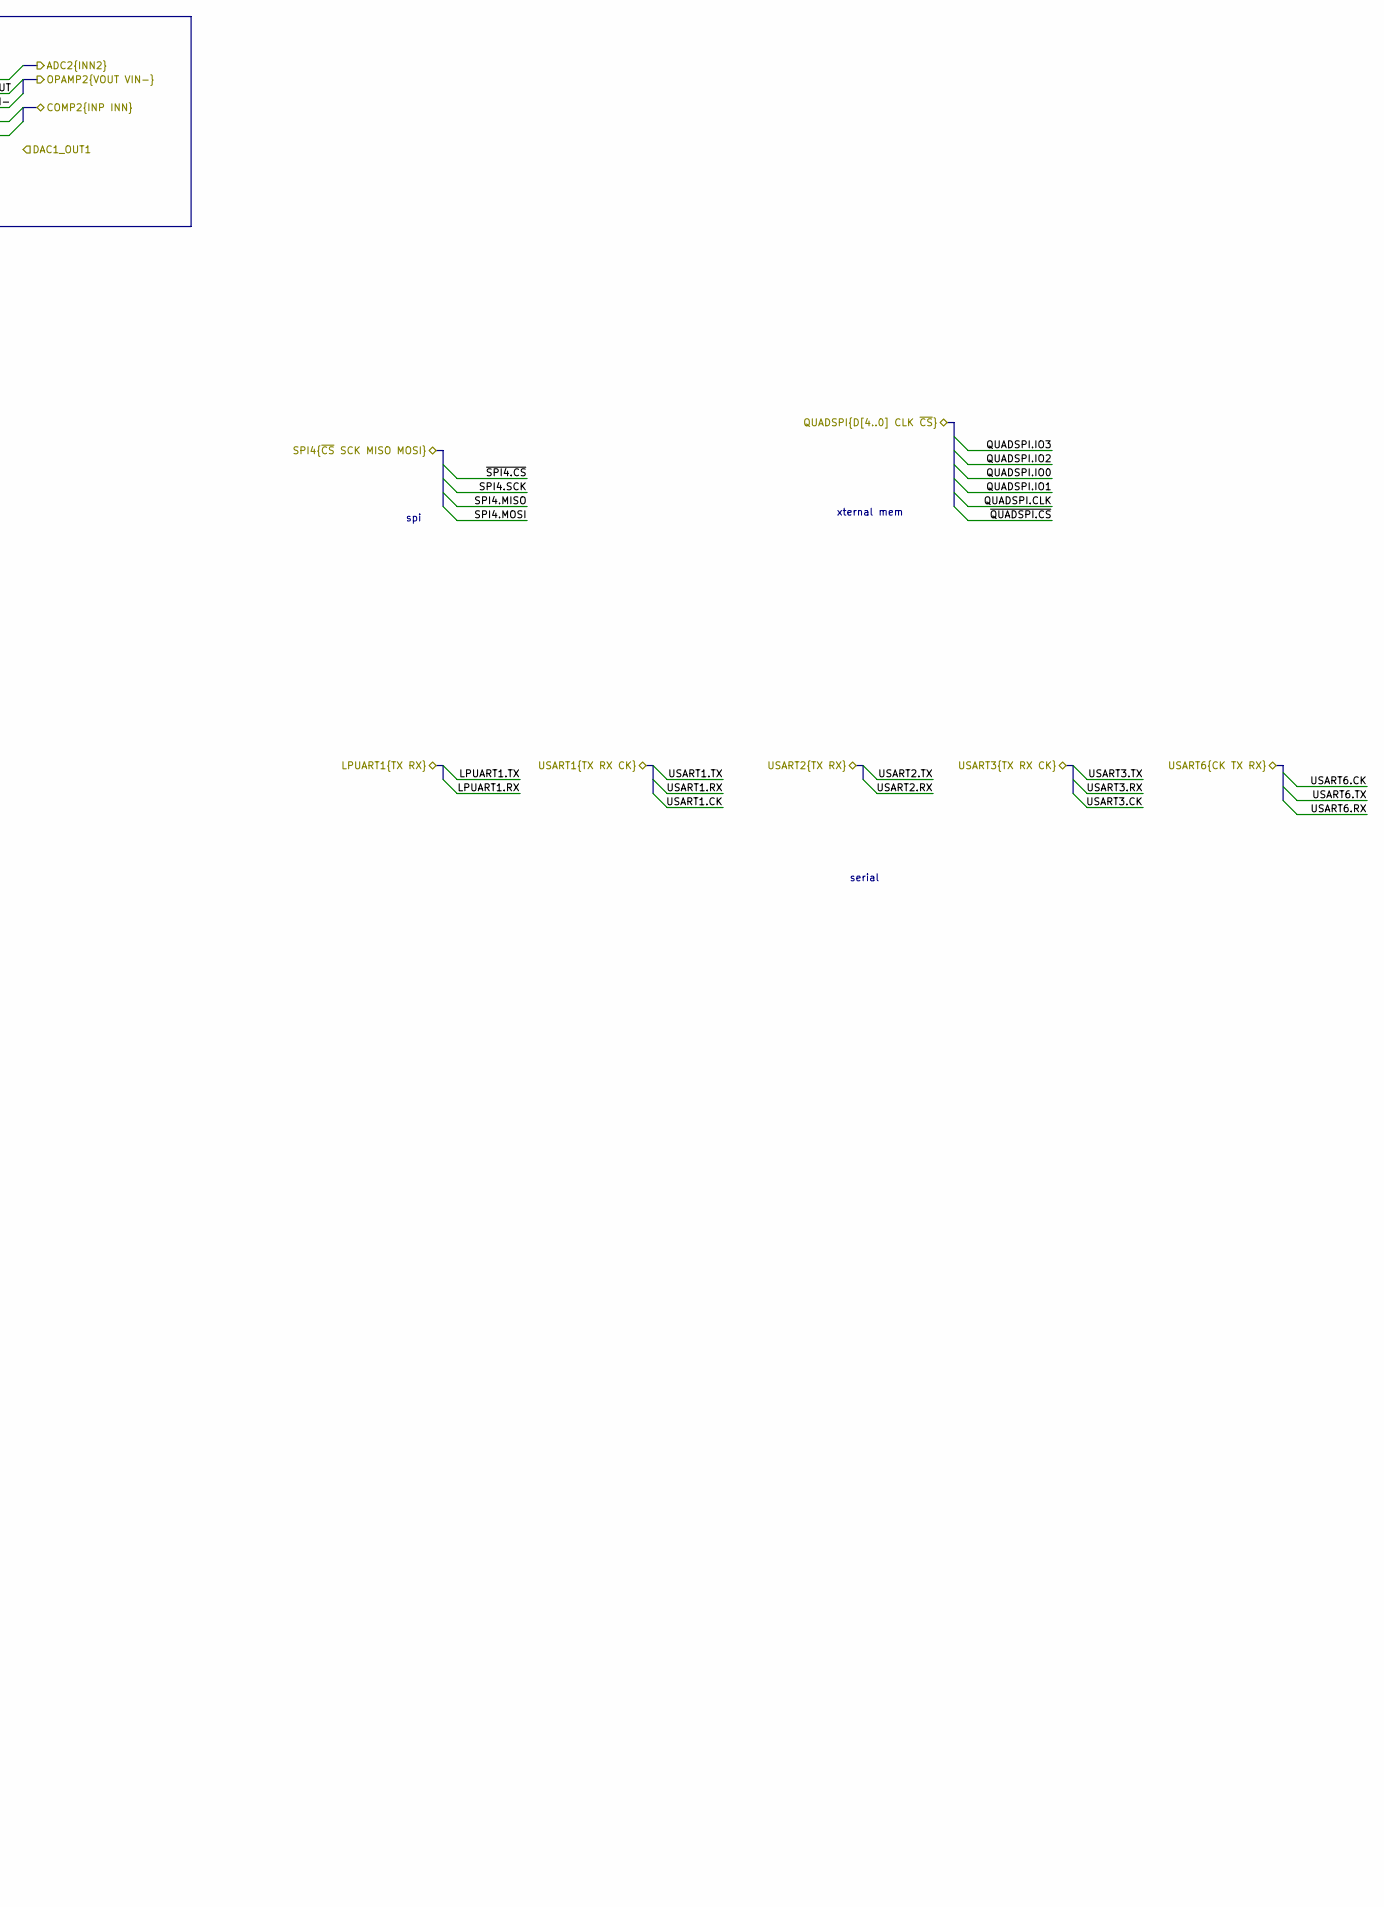
[picture p61: schematic connector.kicad_sch, part in row 1, column 2]

Parts:
J6: Conn_02x05_Counter_Clockwise; PinSocket_2x05_P2.54mm_Vertical
J9: Conn_02x05_Odd_Even; PinHeader_2x05_P2.54mm_Vertical

Connections:
+1.2V: J6.5; also elsewhere on the board
+1.8V: J6.4; also elsewhere on the board
+2.5V: J6.3; also elsewhere on the board
+3.3V: J6.2, J9.7, J9.8; also elsewhere on the board
+5V: J6.1, J9.9, J9.10; also elsewhere on the board
/Connector/NRST: J9.1; also elsewhere on the board
GND: J6.6, J6.7, J6.8, J6.9, J6.10, J9.3, J9.4; also elsewhere on the board
SWCLK: J9.6; also elsewhere on the board
SWDIO: J9.2; also elsewhere on the board

Notes on the sheet:
camera
serial
NO CONNECTORS FOR V1!!
Analog
spi
timer
Power connector
SWD
i2c bus
audio
xternal mem
power
can bus
boot
timekeeping

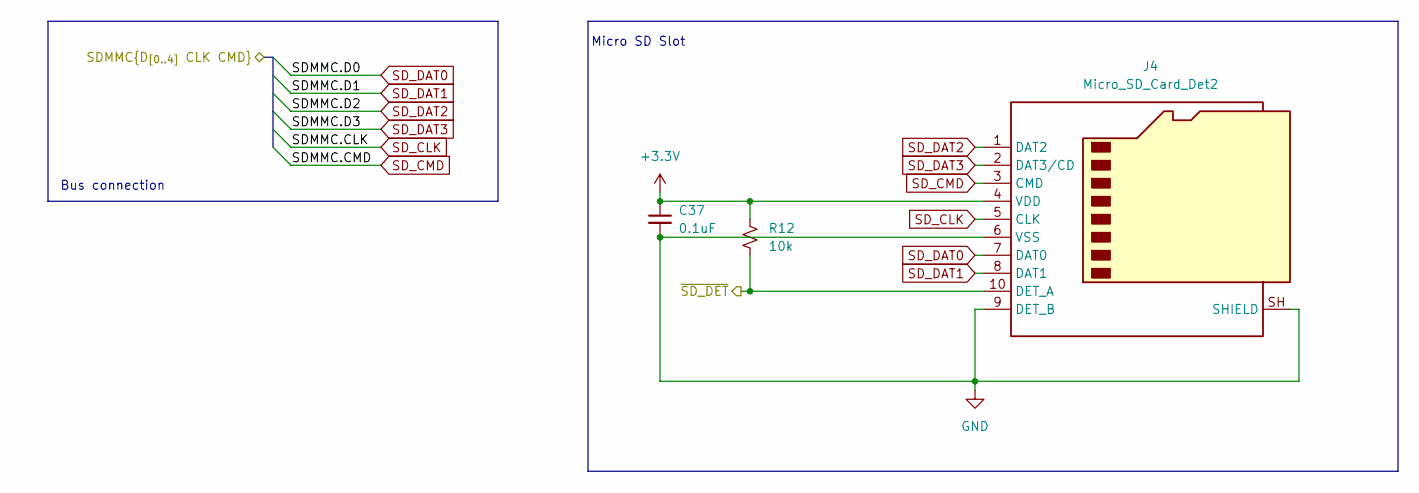
[picture p62: schematic uSD.kicad_sch]

Parts:
C37: 0.1uF; C_0603_1608Metric
J4: Micro_SD_Card_Det2; microSD_HC_Hirose_DM3D-SF
R12: 10k; R_0603_1608Metric

Connections:
+3.3V: C37.1, J4.4 (VDD), R12.1; also elsewhere on the board
/MCU/~SD_DET: J4.10 (DET_A), R12.2; also elsewhere on the board
GND: C37.2, J4.6 (VSS), J4.9 (DET_B), J4.SH (SHIELD); also elsewhere on the board
SD_CLK: J4.5 (CLK); also elsewhere on the board
SD_CMD: J4.3 (CMD); also elsewhere on the board
SD_DAT0: J4.7 (DAT0); also elsewhere on the board
SD_DAT1: J4.8 (DAT1); also elsewhere on the board
SD_DAT2: J4.1 (DAT2); also elsewhere on the board
SD_DAT3: J4.2 (DAT3/CD); also elsewhere on the board

Notes on the sheet:
Micro SD Slot
Bus connection

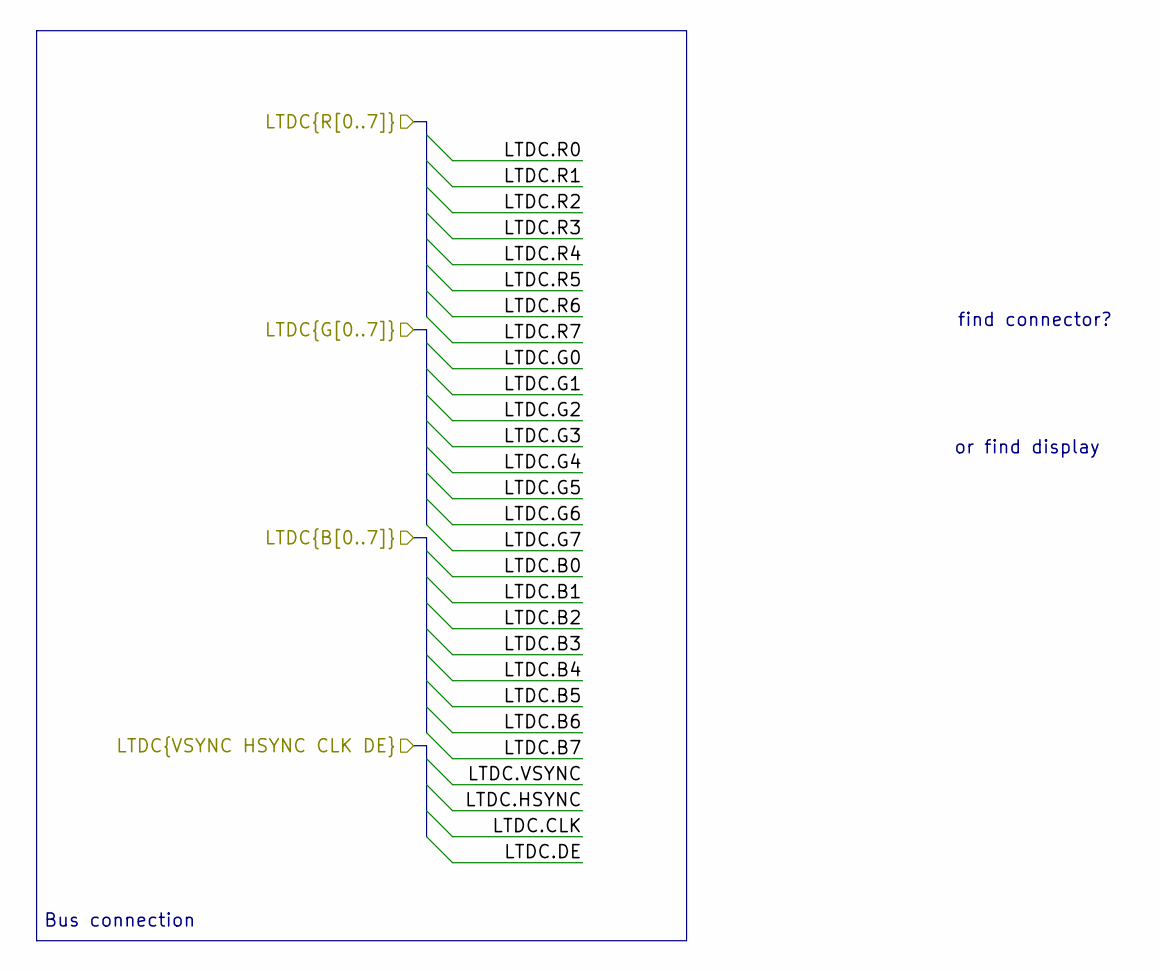
[picture p63: schematic ltdc.kicad_sch]

Notes on the sheet:
Bus connection
or find display
find connector?

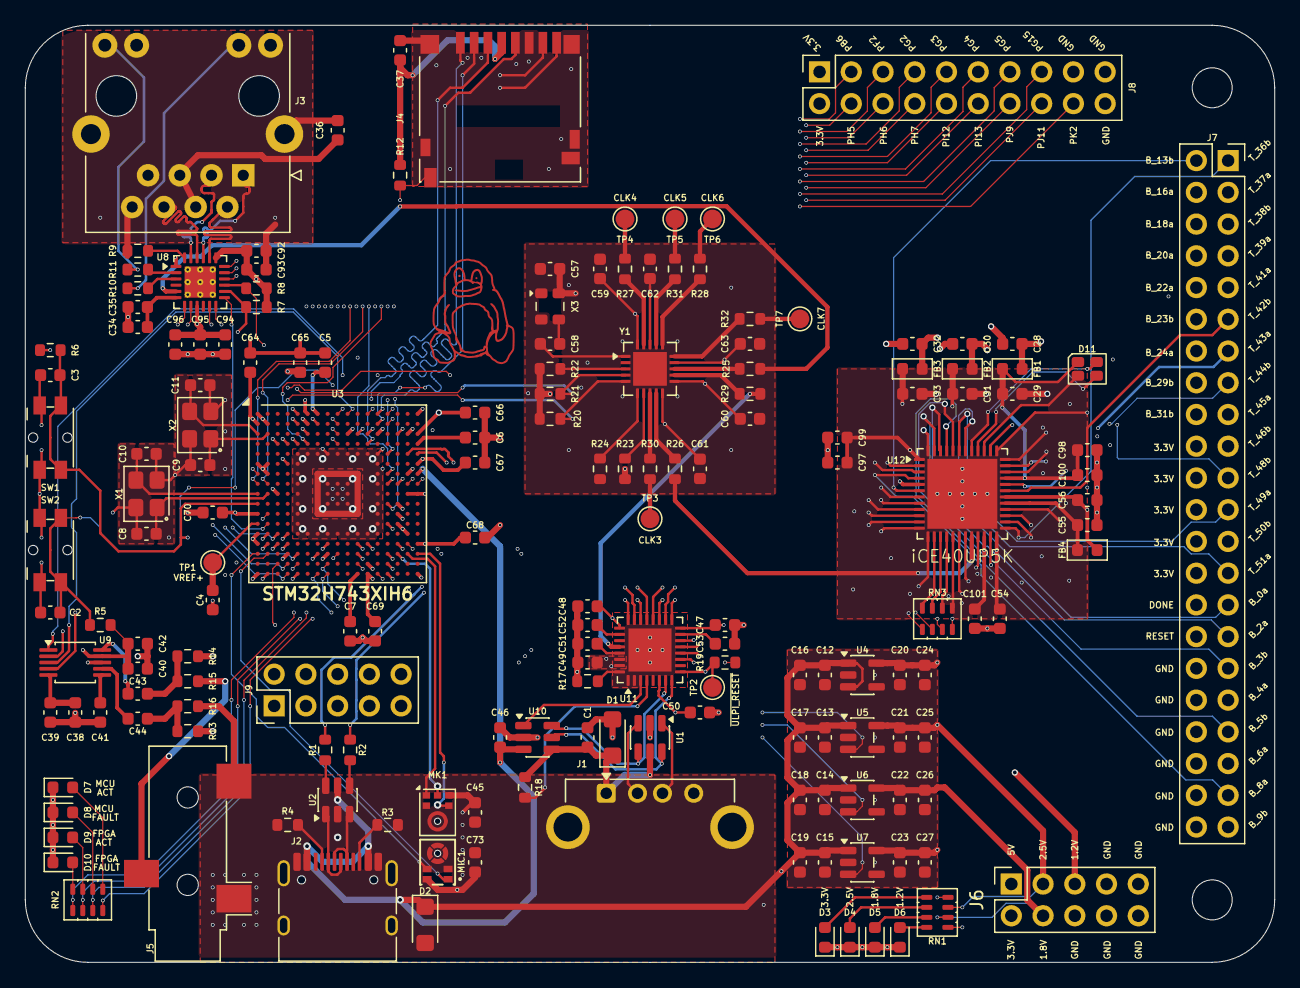
[picture p64: board STM32H743.kicad_pcb from above]

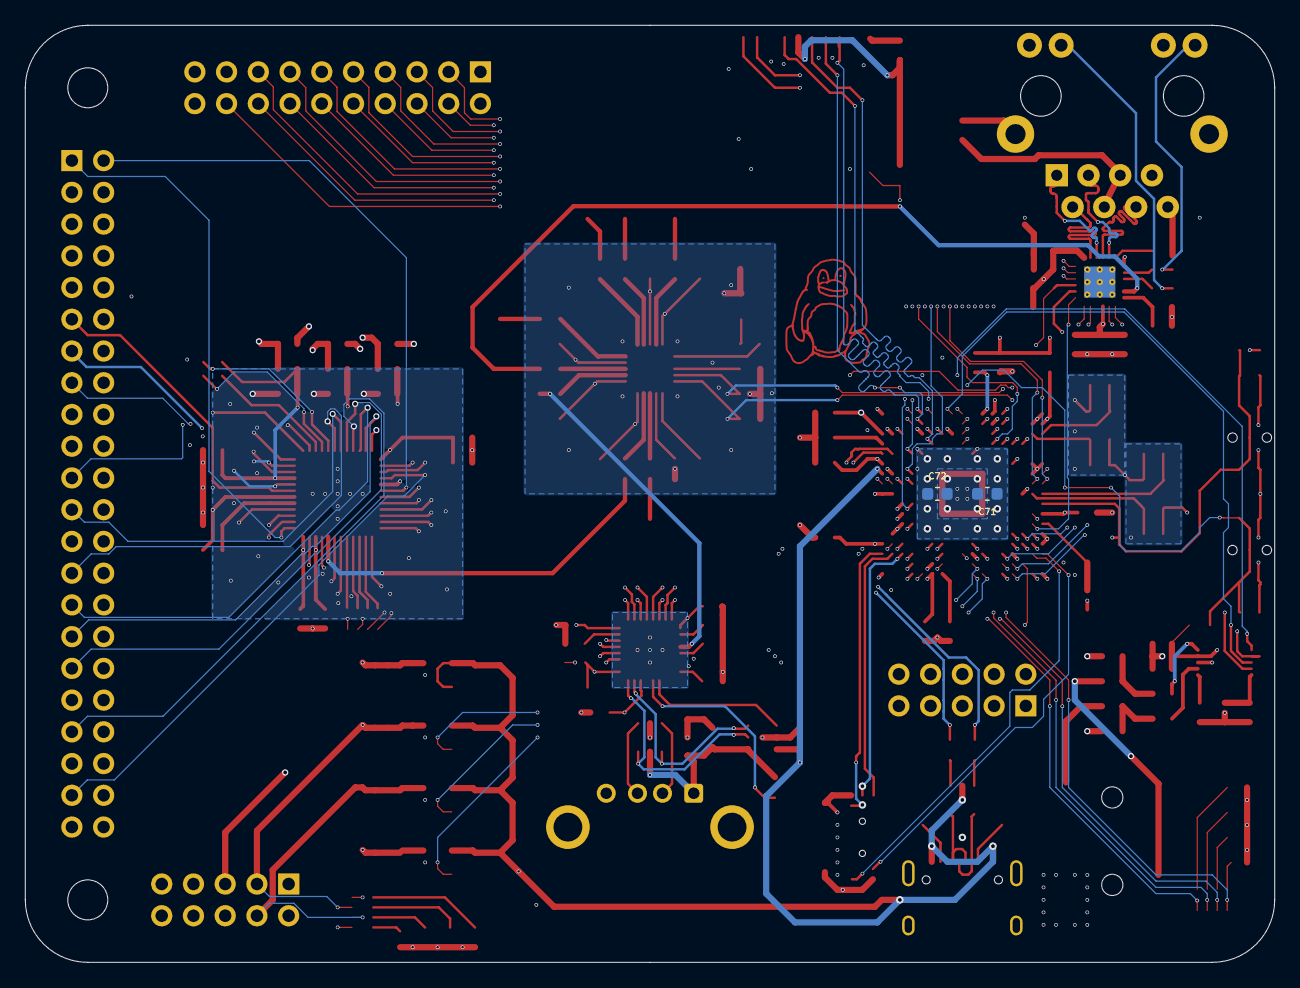
[picture p65: board STM32H743.kicad_pcb from below]

Board: 6 copper layers, 100.0 x 75.0 mm, 171 parts (2 on the bottom side), 196 nets.
