sneakylizard123-4/STM32H743/(commit log)

2026-10-07 many updates
    [ADV7513BSWZ.step, STM32H743.kicad_pcb, STM32H743.kicad_sch, audio.kicad_sch, clock.kicad_sch, connector.kicad_sch, ethernet.kicad_sch, fpga.kicad_sch]
2026-10-22 school wifi broken
    [STM32H743.kicad_pcb, STM32H743.kicad_sch, audio.kicad_sch, clock.kicad_sch, connector.kicad_sch, ethernet.kicad_sch, fpga.kicad_sch, fpgaperipherals.kicad_sch]
2026-10-26 small fixes
    [fpgaperipherals.kicad_sch, sensors.kicad_sch]
2026-10-27 new render with silkscreen and lighting fixes
2026-10-27 add time
    [STM32H743XIH6.blend]
